elegooofficial/Jupiter/README.md

# Jupiter
Opensource files for ELEGOO Jupiter 6k mono LCD 3D printer
