elegooofficial/Jupiter/Jupiter PCB/Jupiter-Constant-current module/原理图.png

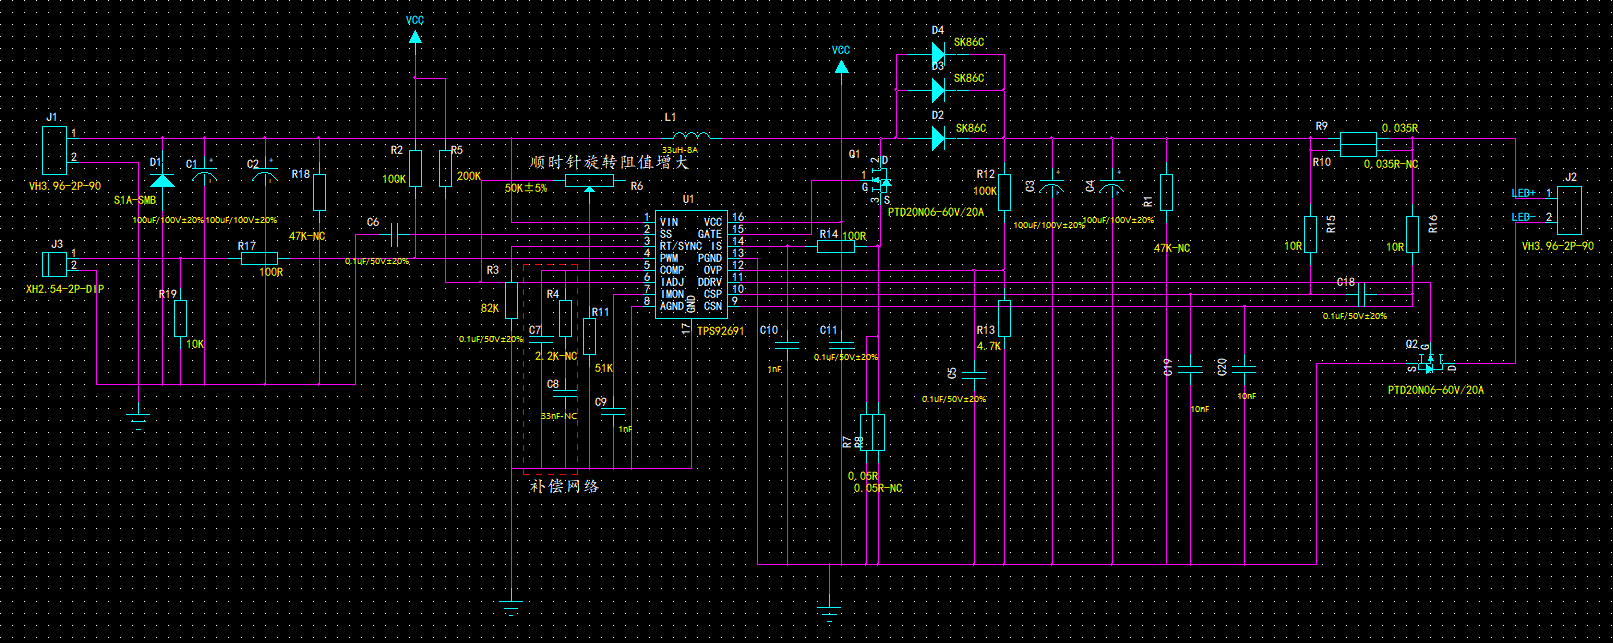
Jupiter PCB/Jupiter-Constant-current module/原理图.png
