elegooofficial/Jupiter/Jupiter BOM-V11.xlsx

研发专用附表 |  |  |  |  |  |  |  | ( Jupiter )BOM
成品料号 |  | 14.0023.01 | 14.0023.02 | 14.0023.03 | 14.0023.05 | 14.0023.04 | 14.0023.06 | S/N | Name | Specification | Qty
取用列 | 不共用物料明细 |  |  |  |  |  |  | 1 | US Power Cord - 1m | Three holes 3*0.824 square, 1m length | 1
#REF! | 料号 | 04.008.0009 | 04.008.0008 | 04.008.0010 | 04.008.0011 | 04.008.0012 | 04.008.0013 | 2 | Jupiter Base Plate | Material: SPCC T=1.5mm, powder black Size: 495*355*62.5mm | 1
#REF! | 名称 | 国标电源线-1m | 美规电源线-1m | 欧规电源线-1m | 英规电源线-1m | 澳规电源线-1m | 巴西规电源线-1m | 3 | Jupiter Bottom Front Left Profile | Material: 6061 aluminum alloy, sandblasted oxidized jujube red Size: 50*25*200mm | 1
#REF! | 规格 | 品字尾 三孔 3*0.75平方 长度1m | 品字尾 三孔 3*0.824平方 长度1m | 品字尾 三孔 3*0.75平方 长度1m | 品字尾 三孔 3*0.75平方 长度1m | 品字尾 三孔 3*0.75平方 长度1m | 品字尾 三孔 3*0.75平方 长度1.0m | 4 | Jupiter Bottom Front Right Profile | Material: 6061 aluminum alloy, sandblasted oxidized jujube red Size: 50*25*200mm | 1
#REF! | 数量 | 1 | 1 | 1 | 1 | 1 | 1 | 5 | Jupiter Bottom Rear Left Profile | Material: 6061 aluminum alloy, sandblasted oxidized black Size: 50*25*200mm | 1
#REF! | 料号 |  |  |  |  |  |  | 6 | Jupiter Bottom Rear Right Profile | Material: 6061 aluminum alloy, sandblasted oxidized black Size: 50*25*200mm | 1
#REF! | 名称 |  |  |  |  |  |  | 7 | Jupiter Bottom Rear Mid Profile | Material: 6061 aluminum alloy, sandblasted oxidized black Size: 50*25*200mm | 1
#REF! | 规格 |  |  |  |  |  |  | 8 | Jupiter Heatsink | Copper tube + heat dissipation aluminum sheet See drawings | 1
#REF! | 数量 |  |  |  |  |  |  | 9 | Jupiter Lens Holder | Plastic parts Size: 100*85*15.4mm | 1
#REF! | 料号 |  |  |  |  |  |  | 10 | Jupiter Lens Silicone Gasket | Material: black silicone Size: 100*85*1.5mm | 1
#REF! | 名称 |  |  |  |  |  |  | 11 | Jupiter Lens Pressing Plate | Material: SPCC powder black Size: 100*85*1mm | 1
#REF! | 规格 |  |  |  |  |  |  | 12 | Jupiter Hood | Material; ABS black Size: 251.6*152.3*141.6mm | 1
#REF! | 数量 | 1 | 1 | 1 | 1 | 1 | 1 | 13 | Jupiter Lens | Size: 83.43*72.3*26mm | 1
 |  |  |  |  |  |  |  | 14 | Jupiter LED Light Board | 60*60*1.5mm, 64 cores UV405nm | 1
#REF! | 料号 | D1 | D2 | D3 | D4 | D5 | D6 | 15 | Jupiter Pressure Booster Board | Boost constant current 24V input | 1
 |  |  |  |  |  |  |  | 16 | Jupiter Cooling Fan | 9225 wire length 100mm, speed 3000r, with 2pin XH2.54 terminal | 1
#REF! | 名称 | D1 | D2 | D3 | D4 | D5 | D6 | 17 | Jupiter PCB Adapter Board | Size: 60*60*1.6 | 1
#REF! | 规格 | D1 | D2 | D3 | D4 | D5 | D6 | 18 | MARS 2 Series USB Adapter Cable | One end is male 90° angle, and the other end is female. Total length 35cm with shield. | 1
 |  |  |  |  |  |  |  | 19 | Jupiter Ethernet Port Extension Cable | RJ45 Ethernet port extension cable with ears, length 0.5M. | 1
#REF! | 数量 | D1 | D2 | D3 | D4 | D5 | D6 | 20 | Jupiter Foot Pads | Specifications: base 50, rod thickness M10, tooth length 15mm | 4
#REF! | 料号 | E1 | E2 | E3 | E4 | E5 | E6 | 21 | Jupiter Medium Plate | Die casting, oil injection black Size: 495.6*355.8*20mm | 1
#REF! | 名称 | E1 | E2 | E3 | E4 | E5 | E6 | 22 | Jupiter Purifier Motherboard | Size: 31*19*1.6 | 1
#REF! | 规格 | E1 | E2 | E3 | E4 | E5 | E6 | 23 | Jupiter Screen Mounting Plate - Oil Injected Black | Die casting, oil injection black Size: 336.4*205.74*10mm | 1
#REF! | 数量 | E1 | E2 | E3 | E4 | E5 | E6 | 24 | Jupiter LCD Screen Module | 12.8-inch screen + TCON + ultra-clear glass OCA bonding | 1
 |  |  |  |  |  |  |  | 25 | Jupiter Screen Protector | Size: 320*190*0.06, with peelable sticker | 2
#REF! | 料号 | F1 | F2 | F3 | F4 | F5 | F6 | 26 | Jupiter Ball Screw Nut Holder | Material: 6061 aluminum alloy, sandblasted oxidized black Size: 50*39*36mm | 1
#REF! | 名称 | F1 | F2 | F3 | F4 | F5 | F6 | 27 | Jupiter Linear Rails Backplane | Material: 6061 aluminum alloy, sandblasted oxidized black Size: 55*158*464mm | 1
#REF! | 规格 | F1 | F2 | F3 | F4 | F5 | F6 | 28 | Jupiter Z-axis Bottom Motor End Cover | Material: 6061 aluminum alloy, sandblasted oxidized black Size: 210*94.5*12mm | 1
#REF! | 数量 | F1 | F2 | F3 | F4 | F5 | F6 | 29 | Jupiter Z-axis Slider Mounting Plate | Material: 6061 aluminum alloy, sandblasted oxidized black Size: 150*106*10mm | 1
#REF! | 料号 | G1 | G2 | G3 | G4 | G5 | G6 | 30 | Jupiter Ball Screw | Ball screw diameter 16 lead 5, length 435mm | 1
#REF! | 名称 | G1 | G2 | G3 | G4 | G5 | G6 | 31 | Jupiter Couplings | Ball screw coupling plum elastic single and double diaphragm φ26*30*10-8 | 1
#REF! | 规格 | G1 | G2 | G3 | G4 | G5 | G6 | 32 | Jupiter Linear Rails + Slider | BGW15CA, total length of 457mm, 1 line rail + 2 sliders | 2
#REF! | 数量 | G1 | G2 | G3 | G4 | G5 | G6 | 33 | Jupiter Bearing Holder | BF 12 bearing holder+26 bearing | 2
 |  |  |  |  |  |  |  | 34 | Jupiter 57 Motor | 57 stepper motor, shaft diameter 8mm | 1
 |  |  |  |  |  |  |  | 35 | Jupiter Lead Screw Lock Nut | Material: Eco-friendly iron black Size: φ22*16 | 1
 |  |  |  |  |  |  |  | 36 | Jupiter Limit Switch Baffle | Material: SPCC T=2.0, Powder Black Size: 88*12.5*12.5mm | 1
 |  |  |  |  |  |  |  | 37 | MARS 2 Series Photoelectric Limit Switch Upper Shell | PC surface tanning processing | 1
 |  |  |  |  |  |  |  | 38 | MARS 2 Series Photoelectric Limit Switch Lower Case | PC surface tanning processing | 1
 |  |  |  |  |  |  |  | 39 | MARS 2 Series Photoelectric Limit Switch PCB | PCB module | 1
 |  |  |  |  |  |  |  | 40 | Jupiter Die Casting Resin Tank | Die casting, oil injection black, size: 406.6*302*36.9mm | 1
 |  |  |  |  |  |  |  | 41 | 12.8-inch FEP2.0 Release Film | Size: 374*247*0.15mm | 3
 |  |  |  |  |  |  |  | 42 | Jupiter Resin Tank Release Film Protective Film | Size: 337*211*0.06, with peelable sticker | 1
 |  |  |  |  |  |  |  | 43 | Jupiter Screen Fixing Tape 1 | Mara tape size: 288.2*7.7*0.08mm | 1
 |  |  |  |  |  |  |  | 44 | Jupiter Screen Fixing Tape 2 | Mara tape size: 180.5*15.5*0.08mm | 2
 |  |  |  |  |  |  |  | 45 | Jupiter Screen Fixing Tape 3 | Mara tape size: 288.2*16.4*0.08mm | 1
 |  |  |  |  |  |  |  | 46 | Jupiter Build Plate | Material: 6061 aluminum alloy, sandblasted build plate surface, non-build surface sandblasted, oxidized black Size: 286*166*12mm | 1
 |  |  |  |  |  |  |  | 47 | Jupiter Resin Tank Stainless Steel Handle | Specifications: φ10 hole spacing 128, height 35 | 2
 |  |  |  |  |  |  |  | 48 | Jupiter Straight Grain Handle | M8x50 regular iron nickel plated, straight grain handle | 2
 |  |  |  |  |  |  |  | 49 | Jupiter Stainless Steel Double Bend Handle | Stainless steel, hole spacing 75mm, height 35mm | 2
 |  |  |  |  |  |  |  | 50 | Juipter L-shaped Handle | M8XR 80 | 1
 |  |  |  |  |  |  |  | 51 | Jupiter Build Plate Spacer Columns | Material: Eco-friendly iron, nickel-plated, silver Size: φ12*59 | 4
 |  |  |  |  |  |  |  | 52 | Jupiter M5 Cap Nut | M5 Cap Nut 304 stainless steel, salt spray test for 24H | 4
 |  |  |  |  |  |  |  | 53 | Jupiter M10 Lock Nut | M10 Lock Nut 304 stainless steel, salt spray test for 24H | 1
 |  |  |  |  |  |  |  | 54 | Jupiter M8 X40 Leveling Set Positioning Dowels | Material: Eco-friendly iron, nickel-plated, silver Size: φ8*40 | 2
 |  |  |  |  |  |  |  | 55 | M8 Gasket | Size: φ8.5*φ35*3mm, 304 stainless steel, salt spray test for 24H | 1
 |  |  |  |  |  |  |  | 56 | Jupiter Cantilever Risers | Material: 6061 aluminum alloy, sandblasted oxidized black Size: 160.5*80*10mm | 2
 |  |  |  |  |  |  |  | 57 | Jupiter Forming Platform Upper Plate | Material: 6061 aluminum alloy, sandblasted oxidized black Size: 180*87*22mm | 1
 |  |  |  |  |  |  |  | 58 | Jupiter Printing Platform Integral Fixing Plate | Material: 6061 aluminum alloy, sandblasted anodized black Size: 160*85*8mm | 1
 |  |  |  |  |  |  |  | 59 | Jupiter Upper Front Left Profile | Material: 6061 aluminum alloy, sandblasted anodized black Size: 47*25*485mm | 1
 |  |  |  |  |  |  |  | 60 | Jupiter Upper Front Right Profile | Material: 6061 aluminum alloy, sandblasted anodized black Size: 47*25*485mm | 1
 |  |  |  |  |  |  |  | 61 | Jupiter Upper Rear Left Profile | Material: 6061 aluminum alloy, sandblasted anodized black Size: 50*25*485mm | 1
 |  |  |  |  |  |  |  | 62 | Jupiter Upper Rear Right Profile | Material: 6061 aluminum alloy, sandblasted anodized black Size: 50*25*485mm | 1
 |  |  |  |  |  |  |  | 63 | Jupiter Bottom Front Panel | Material: Galvanized sheet T=1.0, powder black Size: 486*202*1.0mm | 1
 |  |  |  |  |  |  |  | 64 | Jupiter Bottom Left Panel | Material: SPCC T=1.0, powder black Size: 346*202*1.0mm | 1
 |  |  |  |  |  |  |  | 65 | Jupiter Bottom Rear Panel | Material: SPCC T=1.0, powder black Size: 346*210*1.0mm | 1
 |  |  |  |  |  |  |  | 66 | Jupiter Bottom Right Panel | Material: SPCC T=1.0, powder black Size: 346*210*1.0mm | 1
 |  |  |  |  |  |  |  | 67 | Jupiter Upper Left Panel | Material: SPCC T=1.0, powder black Size: 493.3*346.5*1.0mm | 1
 |  |  |  |  |  |  |  | 68 | Jupiter Upper Right Panel | Material: SPCC T=1.0, powder black Size: 493.3*346.5*1.0mm | 1
 |  |  |  |  |  |  |  | 69 | Jupiter Upper Back Panel | Material: SPCC T=1.0, powder black Size: 493.3*486*1.0mm | 1
 |  |  |  |  |  |  |  | 70 | Jupiter Top Panel | Material: SPCC T=1.0, powder black Size: 495*354*1.0mm | 1
 |  |  |  |  |  |  |  | 71 | Jupiter Door Panel | Material: SPCC T=2.0, powder black Size: 494*498*2mm | 1
 |  |  |  |  |  |  |  | 72 | Jupiter Vent Cover Plate | Material: SPCC T=1.0, powder black Size: 73*73*1mm | 1
 |  |  |  |  |  |  |  | 73 | Jupiter Motherboard | J2, 12.8-inch 6K driver board, FPGA supports 8K resolution | 1
 |  |  |  |  |  |  |  | 74 | Jupiter 5-inch Touch Screen | Size: 131.6*96.6*1.0mm with adhesive sticker | 1
 |  |  |  |  |  |  |  | 75 | Jupiter Door Magnet | Main body material: 45# steel Size: 46*15*12.8mm; with iron block size 44*12*1.4mm | 1
 |  |  |  |  |  |  |  | 76 | Jupiter Hinge | Material: iron, black Dimensions: 50x15x1.0 | 3
 |  |  |  |  |  |  |  | 77 | Jupiter Aluminum Alloy Door Handle | Material: aluminum alloy, silver Hole spacing 160 | 1
 |  |  |  |  |  |  |  | 78 | Jupiter Machine Handle | Material: all plastic, black Size: 110*50*23.5mm, with mounting nut | 2
 |  |  |  |  |  |  |  | 79 | Jupiter DC Terminal | Specifications: 24V, 10A; all copper material, silver | 1
 |  |  |  |  |  |  |  | 80 | Jupiter Power Switch | KCD4 Boat shape 250V AC 16A 4 feet | 1
 |  |  |  |  |  |  |  | 81 | Jupiter Door Window | Material: PMMA, brown Size: 470*430*4mm | 1
 |  |  |  |  |  |  |  | 82 | Jupiter Resin Tank Press Sheet Upper | Material: SPCC T=3, electrophoretic black Size: 353.3*227*3mm | 1
 |  |  |  |  |  |  |  | 83 | Jupiter Resin Tank Press Sheet Bottom | Material: SPCC T=3, electrophoretic black Size: 353.3*227*3mm | 1
 |  |  |  |  |  |  |  | 84 | Jupiter Fan Adapter Cable | Blue green wire, full length 400mm 0.14RV XH2.54-2P | 1
 |  |  |  |  |  |  |  | 85 | Jupiter Purifier Adapter Cable | White grey wire, full length 400mm 0.14RV XH2.54-2P | 1
 |  |  |  |  |  |  |  | 86 | Jupiter Limit Switch Adapter Cable | Black, red and blue wire, full length 400mm 0.14RV XH2.54-3P | 1
 |  |  |  |  |  |  |  | 87 | Jupiter Motor Adapter Cable | Black, green, red and blue wire, full length 400mm 0.34RV, one end XH2.5-4P-DIP, the other end XH2.54-4P | 1
 |  |  |  |  |  |  |  | 88 | Jupiter Lighting Adapter Cable | Red black wire, full length 400mm 0.34RV, one end VH3.96-2P, the other end KF terminal green, 2PIN spacing 5.08 | 1
 |  |  |  |  |  |  |  | 89 | Jupiter Booster Board to Motherboard Cable | Red black wire, full length 400mm, 1.0RV, one end VH3.96-2P, the other end KF terminal green, 2PIN spacing 5.08 | 1
 |  |  |  |  |  |  |  | 90 | Jupiter Purifier Cable | Red black wire, full length 200mm 0.14RV XH2.54-2P | 1
 |  |  |  |  |  |  |  | 91 | Jupiter Limit Switch Cable | Red black wire, full length 200mm 0.14RV XH2.54-3P | 1
 |  |  |  |  |  |  |  | 92 | Jupiter Motor Cable | Black, green, red and blue wire, full length 200mm 0.34RV, one end XH2.5-11P-DIP, the other end XH2.54-4P | 1
 |  |  |  |  |  |  |  | 93 | Jupiter Lighting Cable | Black red wire, full length 710mm 0.34RV, one end SM, the other end VH3.96-2P | 1
 |  |  |  |  |  |  |  | 94 | Jupiter DC Terminal to Motherboard Cable | The red wire is 430mm long, the black wire is 480mm long 1.0RV; one end is KF terminal green, 2PIN spacing 5.08, the red wire at the other end is 6.3 spring terminal + sheath. | 1
 |  |  |  |  |  |  |  | 95 | Jupiter DC Switch Cable | Red wire, full length 80mm 1.0RV, one end of red wire with 6.3 spring terminal + sheath, the other end with tin. | 1
 |  |  |  |  |  |  |  | 96 | Jupiter LED Light Board to Booster Board | Black red wire, full length 250mm 1.0RV, one end VH3.96 -2P, the other end with tin. | 1
 |  |  |  |  |  |  |  | 97 | Jupiter LED Light | 2 lights in series, full length 150mm 0.34RV SM 2700 lumens | 1
 |  |  |  |  |  |  |  | 98 | Jupiter LCD Screen Cable Layout | Same direction, full length 250mm, impedance 100 40pin | 1
 |  |  |  |  |  |  |  | 99 | Jupiter Touch Screen Cable Layout | Co-directional unidirectional shielding, length 150mm, 0.5 spacing 40pin | 1
 |  |  |  |  |  |  |  | 100 | Jupiter Adapter | Specifications: 24V 7.5A Dc5.5-2.5 elbow, cable length 1.2m | 1
 |  |  |  |  |  |  |  | 101 | Jupiter Handle Bolt | Material: Eco-friendly iron, nickel-plated, silver Size: φ10*70 | 1
 |  |  |  |  |  |  |  | 102 | Jupiter Profile Fastening Dowels | M8*30 fastening positioning pin | 8
 |  |  |  |  |  |  |  | 103 | Headless Hexagon Socket Head Screws | M5*6 304 stainless steel concave end, salt spray test for 24H | 8
 |  |  |  |  |  |  |  | 104 | M4 Nuts | M4 stainless steel hex nut | 9
 |  |  |  |  |  |  |  | 105 | M4 Flange Nuts | M4 flange nut, stainless steel 304 silver, salt spray test for 24H | 6
 |  |  |  |  |  |  |  | 106 | Cup Head Hexagon Socket Screws | M4*8 carbon steel, hardened, black zinc plated, salt spray test for 24H | 4
 |  |  |  |  |  |  |  | 107 | Button Head Hexagon Socket Screws | M4*6 carbon steel, hardened, black zinc plated, salt spray test for 24H | 81
 |  |  |  |  |  |  |  | 108 | Button Head Hexagon Socket Screws | M3*6 carbon steel, hardened, black zinc plated, salt spray test for 24H | 4
 |  |  |  |  |  |  |  | 109 | Cup Head Hexagon Socket Screws | M5*20 stainless steel 304 silver, salt spray test for 24H | 18
 |  |  |  |  |  |  |  | 110 | Cup Head Hexagon Socket Screws | M3*5 stainless steel 304 silver, salt spra test for 24H | 26
 |  |  |  |  |  |  |  | 111 | Cup Head Hexagon Socket Screws | M4*8 stainless steel 304 silver, salt spray test for 24H | 14
 |  |  |  |  |  |  |  | 112 | Cup Head Hexagon Socket Screws | M4*22 stainless steel 304 silver, salt spray test for 24H | 4
 |  |  |  |  |  |  |  | 113 | Cup Head Hexagon Socket Screws | M3*14 stainless steel 304 silver, salt spray test for 24H | 2
 |  |  |  |  |  |  |  | 114 | Flat Head Hexagon Socket Screws | M4*8 stainless steel 304 silver, salt spray test for 24H | 8
 |  |  |  |  |  |  |  | 115 | Flat Head Hexagon Socket Screws | M4*6 stainless steel 304 silver, salt spray test for 24H | 47
 |  |  |  |  |  |  |  | 116 | Flat Head Hexagon Socket Screws | M4*14 stainless steel 304 silver, salt spray test for 24H | 25
 |  |  |  |  |  |  |  | 117 | Jupiter Leveling Screws | Cup head hexagon socket screws, M5*12 stainless steel 304 silver, salt spray test for 24H, chamfered bottom of thread, smooth bottom of screw | 4
 |  |  |  |  |  |  |  | 118 | Cup Head Hexagon Socket Screws | M4*10 stainless steel 304 silver, salt spray test for 24H | 24
 |  |  |  |  |  |  |  | 119 | Cup Head Hexagon Socket Screws | M5*12 stainless steel 304 silver, salt spray test for 24H | 38
 |  |  |  |  |  |  |  | 120 | Cup Head Hexagon Socket Screws | M4*14 stainless steel 304 silver, salt spray test for 24H | 16
 |  |  |  |  |  |  |  | 121 | Cup Head Hexagon Socket Screws | M5*30 stainless steel 304 silver, salt spray test for 24H | 4
 |  |  |  |  |  |  |  | 122 | Cup Head Hexagon Socket Screws | M5*14 stainless steel 304 silver, salt spray test for 24H | 14
 |  |  |  |  |  |  |  | 123 | Cup Head Hexagon Socket Screws | M6*35 stainless steel 304 silver, salt spray test for 24H | 4
 |  |  |  |  |  |  |  | 124 | Cup Head Hexagon Socket Screws | M3*10 stainless steel 304 silver, salt spray test for 24H | 4
 |  |  |  |  |  |  |  | 125 | Button Head Hexagon Socket Screws Black | M4*10 carbon steel, hardened, black zinc plated, salt spray test for 24H | 9
 |  |  |  |  |  |  |  | 126 | Flat Head Hexagon Socket Screws | M3*5 carbon steel, hardened, black zinc plated, salt spray test for 24H | 2
 |  |  |  |  |  |  |  | 127 | Flat Head Hexagon Socket Screws | M3*8 carbon steel, hardened, black zinc plated, salt spray test for 24H | 2
 |  |  |  |  |  |  |  | 128 | Spring | Die spring, nickel-plated, treatment salt spray for 24H, outer diameter 8mm, length 15mm | 4
 |  |  |  |  |  |  |  | 129 | Jupiter Protective Film Removable | 75 filament synthetic paper complex coating film, 30*10mm glueless part 7mm | 2
 |  |  |  |  |  |  |  | 130 | CHITUBOX Pro Key Card | Card size: 85.6*53.98mm + key reference code | 1
 |  |  |  |  |  |  |  | 131 | U Disk | 4G | 1
 |  |  |  |  |  |  |  | 132 | Acetate Tape | Width 10mm, black (tape length 30m/roll) | 0.12
 |  |  |  |  |  |  |  | 133 | Jupiter Cable Fastener | 13*10*7mm, black, clip 2-3mm wide | 4
 |  |  |  |  |  |  |  | 134 | Scraper | Specifications: 4 inch, oblique incision | 1
 |  |  |  |  |  |  |  | 135 | Jupiter Auto Feeding Bottle Cap |  | 5
 |  |  |  |  |  |  |  | 136 | SAT S USB Air Purifier | 44*44*169mm; with user manual | 1
 |  |  |  |  |  |  |  | 137 | Mask |  | 2
 |  |  |  |  |  |  |  | 138 | Gloves | Latex gloves, large size | 2双
 |  |  |  |  |  |  |  | 139 | Plastic Scraper | Material: PP, yellow | 1
 |  |  |  |  |  |  |  | 140 | Hexagon Socket Head Screwdriver with Straight Handle | H2.5*75mm; chrome vanadium steel | 1
 |  |  |  |  |  |  |  | 141 | Allen Wrench | M3 full length 91mm, length error ±5mm, S2 alloy | 1
 |  |  |  |  |  |  |  | 142 | Allen Wrench | M4 length 90mm, S2 alloy | 1
 |  |  |  |  |  |  |  | 143 | Paper Funnel |  | 10
 |  |  |  |  |  |  |  | 144 | Pliers | Long 130mm, wide 76mm, stainless steel jaws, Non-slip rubber handle | 1
 |  |  |  |  |  |  |  | 145 | Nylon Cable Tie | 2*150mm, black | 5
 |  |  |  |  |  |  |  | 146 | Jupiter Leveling Instruction Card | 296*176*0.15mm, 157g double copper glue, single-sided printing | 1
 |  |  |  |  |  |  |  | 147 | Jupiter User Manual | 150*150mm, saddle stud, matte powder 105g | 1
 |  |  |  |  |  |  |  | 148 | Zip-lock Bag | 100*150mm | 3
 |  |  |  |  |  |  |  | 149 | Zip-lock Bag | 180mm*160mm*0.06mm | 1
 |  |  |  |  |  |  |  | 150 | Jupiter Label Nameplate | 90*55mm, single side self-adhesive | 1
 |  |  |  |  |  |  |  | 151 | Jupiter Slicing Software | CHITUBOX | 1
 |  |  |  |  |  |  |  | 152 | Heat Shrink Tube | Specifications: φ3*20mm, inner diameter 3.5mm; wall thickness 0.2mm | 2
 |  |  |  |  |  |  |  | 153 | Thermal Conductive Silicone Grease | Thermal paste, gold, thermal conductivity greater than 3.05 | 0.2
 |  |  |  |  |  |  |  | 154 | Jupiter Accessories Box | Material: PP, ink black; Size: 334*235*60mm | 1
 |  |  |  |  |  |  |  | 155 | Jupiter FEP Film Packaging Box | 48*48*273mm, 250g, single powder+wf | 1
 |  |  |  |  |  |  |  | 156 | Jupiter Carton Box | Material: K6#K three pits; Box size: 630*435*775mm | 1
 |  |  |  |  |  |  |  | 157 | Jupiter Carton Lid | Material: K6#K three pits; Box lid size: 635*100*455mm | 2
 |  |  |  |  |  |  |  | 158 | Jupiter Upper Foam | White EPE; Size 600*420*280mm | 1
 |  |  |  |  |  |  |  | 159 | Jupiter Bottom Foam | White EPE; Size 600*420*335mm | 1
 |  |  |  |  |  |  |  | 160 | Jupiter Screen Protection Foam | White EPE; Size 155*18*100mm | 1
 |  |  |  |  |  |  |  | 161 | Jupiter Internal Foam 1 | White EPE; Size 480*445*10mm | 1
 |  |  |  |  |  |  |  | 162 | Jupiter Internal Foam 2 | White EPE; Size 490*260*373mm | 1
 |  |  |  |  |  |  |  | 163 | Jupiter Internal Foam 3 | White EPE; Size 320*185*105mm | 1
 |  |  |  |  |  |  |  | 164 | Jupiter Shipping Box Lid | Size: 685*505*100mm, Material: high-strength special reloading paper, face paper and lining paper 447g, corrugated paper 150g, medium paper 140g (7 layers) | 2
 |  |  |  |  |  |  |  | 165 | Jupiter Shipping Box Body | Size: 665*490*810mm, Material: high-strength special reloading paper, face paper and lining paper 447g, corrugated paper 150g, medium paper 140g (7 layers) | 1
 |  |  |  |  |  |  |  | 166 | Jupiter Upper Double-sided Tape | 3M 9448A, temperature resistance 210 degrees, double-sided adhesive black, size 290*4*0.15mm | 1
 |  |  |  |  |  |  |  | 167 | Jupiter Bottom Double-sided Tape | 3M 9448A, temperature resistance 210 degrees, double-sided adhesive black, size 290*1.8*0.15mm | 1
 |  |  |  |  |  |  |  | 168 | Jupiter Double Sided Tape | 3M 9448A, temperature resistance 210 degrees, double-sided adhesive black, size 154*6*0.15mm | 2
 |  |  |  |  |  |  |  | 169 | Jupiter Build Plate Protection EPE | White EPE conventional 18KG; size: 280*80*30mm, dimensional tolerance ±3mm | 2
