elegooofficial/Jupiter/Jupiter PCB/Jupiter-Constant-current module/BOM-08.001.0011-Jupiter升压板-20220616-V5.0.xlsx

项目 | 用量 | 参考编号 | 元件规格名称 | Value | 指定供应商 | 参考购买链接
1 | 5 | C5,C6,C7,C11,C18 | 0603,0.1uF/50V±20% | 0.1uF | * | *
2 | 2 | C19,C20 | 0603,10nF/50V±20% | 10nF | * | *
3 | 2 | C9.C10 | 0603,1nF/50V±20% | 1nF | * | *
4 | 2 | R2,R12 | 0603,100K±1% | 100K | * | *
5 | 2 | R14,R17 | 0603,100R±1% | 100R | * | *
6 | 2 | R15,R16 | 0603,10R±1% | 10R | * | *
7 | 1 | R5 | 0603,200K±1% | 200K | * | *
8 | 1 | R13 | 0603,4.7K±1% | 4.7K | * | *
9 | 1 | R19 | 0603,10K±1% | 10K | * | *
10 | 1 | R11 | 0603,50K±1% | 50K | * | *
11 | 1 | R3 | 0603,82K±1% | 82K | * | *
12 | 1 | R9 | 2512,0.035R±1% | 0.035R | 中国台湾-大毅 | https://item.szlcsc.com/370321.html
13 | 1 | R7 | 2512,0.05R±1% | 0.05R | 中国台湾-厚生 | https://item.szlcsc.com/138981.html
14 | 4 | C1,C2,C3,C4 | CAP-DIP-L10-H16,100uF/100V±20% | 100uF/100V±20% | 中国-湖南艾华AISHI | https://item.szlcsc.com/107895.html
15 | 1 | D1 | S1A | S1A | 中国-山东晶导微电子 | https://item.szlcsc.com/436172.html
16 | 2 | D2,D4 | SK86C | SK86C-60V/8A | 中国-江苏辰达行电子MDD | https://item.szlcsc.com/65405.html
17 | 1 | L1 | 33uH | 33uH-8A | 韩国-顺磁Sunltech | https://item.szlcsc.com/938420.html
18 | 1 | Q2 | AS3100 | NMOS-AS3100 | 中国台湾-安邦AnBon | https://item.taobao.com/item.htm?id=649348877533&ns=1&abbucket=2
19 | 1 | Q1 | PTD20N06 | PTD20N06-60V/20A | 中国-深圳市迪浦电子有限公司PUOLOP(迪浦) | https://item.szlcsc.com/486296.html
20 | 1 | R6 | 3296W,50K±5% | 50K±5% | 中国-成都国盛科技有限公司BocHen(博晨) | https://item.szlcsc.com/120180.html
21 | 1 | U1 | TPS92691PWPR | TPS92691PWPR | 美国-德州仪器TI | https://item.taobao.com/item.htm?id=649805442109&ns=1&abbucket=2
22 | 2 | J1,J2 | VH3.96-2P-90,弯针 | VH3.96-2P-90 | * | *
23 | 1 | J3 | XH2.54-2P,直针 |  | * | *
