elegooofficial/Jupiter/Jupiter PCB/Jupiter-PCB Adapter Board/Jupiter PCB BOM.xls

数量 | 参考编号 | 元件名称 | 规格型号
4 | J1,J2,J3,J4 | XH2.54-2P | 直针
2 | J5,J6 | XH2.54-3P | 直针
2 | J7,J10 | XH2.54-4P | 直针
2 | J8,J9 | VH3.96-2P | 直针
1 | C1 | 0.1uF/50V±20% | 0603
1 | C2 | 10uF/50V±20% | 1206
