elegooofficial/Jupiter/Jupiter Mechanical/ASM/Jupiter Upper Back Panel.SLDPRT

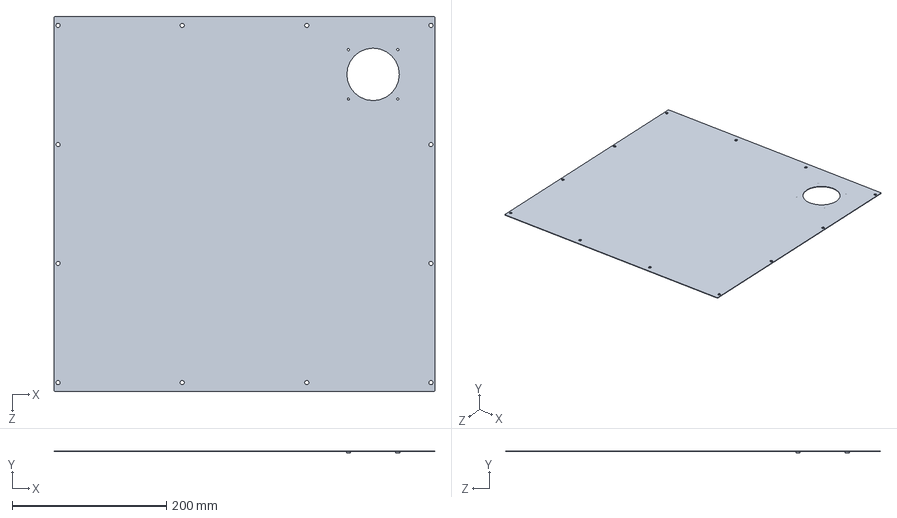
[picture p2: CAD file, 2022-12-16]
Jupiter Mechanical/ASM/Jupiter Upper Back Panel.SLDPRT
493.3 x 3.00 x 486.0 mm
