elegooofficial/Jupiter/Jupiter Mechanical/STP/Jupiter Bottom Front Panel.STEP

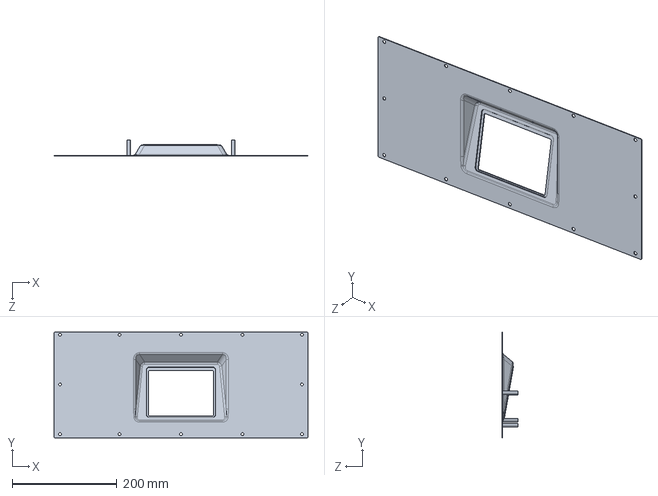
[picture p3: CAD file, 2022-12-16]
Jupiter Mechanical/STP/Jupiter Bottom Front Panel.STEP
486.0 x 202.0 x 30.0 mm
