elegooofficial/Jupiter/Jupiter Mechanical/ASM/Jupiter Door Panel.SLDPRT

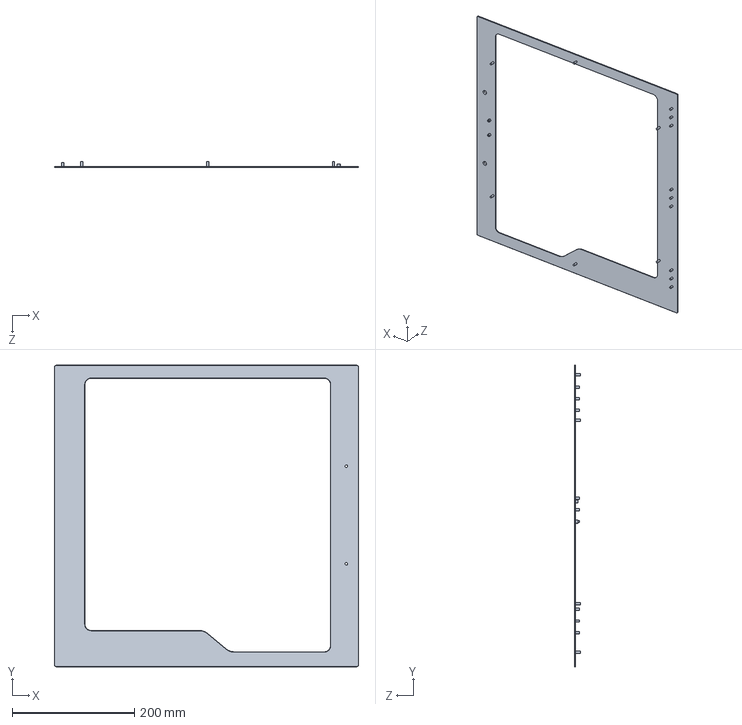
[picture p4: CAD file, 2022-12-16]
Jupiter Mechanical/ASM/Jupiter Door Panel.SLDPRT
498.0 x 494.0 x 10.0 mm
