elegooofficial/Jupiter/Jupiter Mechanical/ASM/Jupiter Bearing Holder.SLDPRT

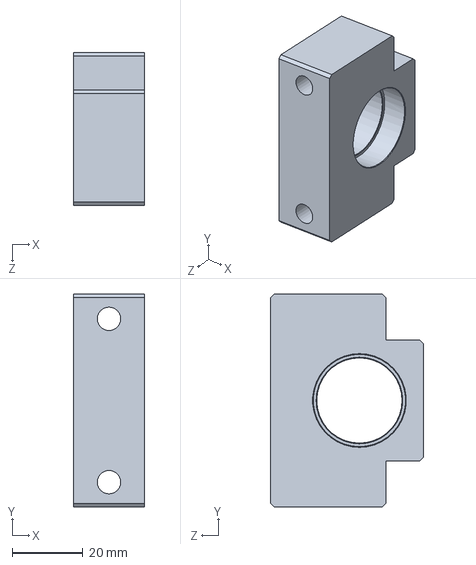
[picture p6: CAD file, 2022-12-16]
Jupiter Mechanical/ASM/Jupiter Bearing Holder.SLDPRT
20.0 x 60.0 x 43.0 mm
