elegooofficial/Jupiter/Jupiter Mechanical/STP/Jupiter Printing Platform Integral Fixing Plate.STEP

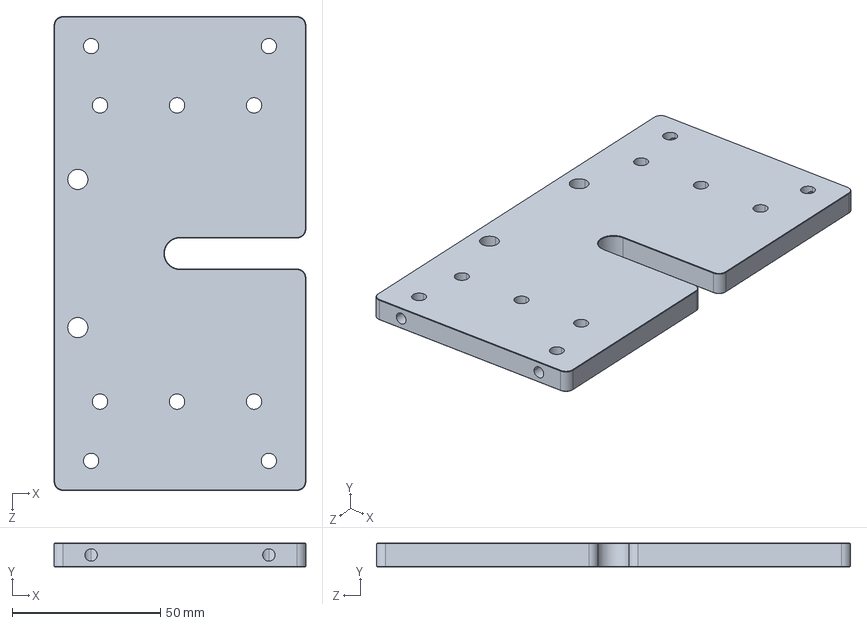
[picture p7: CAD file, 2022-12-16]
Jupiter Mechanical/STP/Jupiter Printing Platform Integral Fixing Plate.STEP
85.0 x 8.00 x 160.0 mm
