elegooofficial/Jupiter/Jupiter Mechanical/ASM/Jupiter Z-axis Slider Mounting Plate.SLDPRT

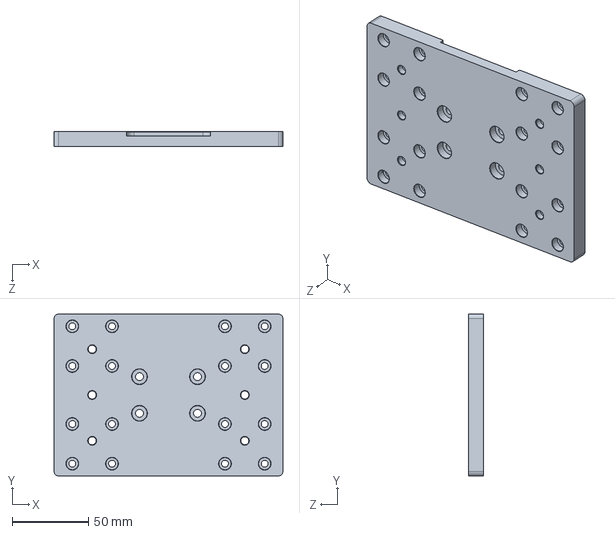
[picture p8: CAD file, 2022-12-16]
Jupiter Mechanical/ASM/Jupiter Z-axis Slider Mounting Plate.SLDPRT
150.0 x 106.0 x 10.0 mm
