elegooofficial/Jupiter/Jupiter Mechanical/STP/Jupiter Upper Front Left Profile.STEP

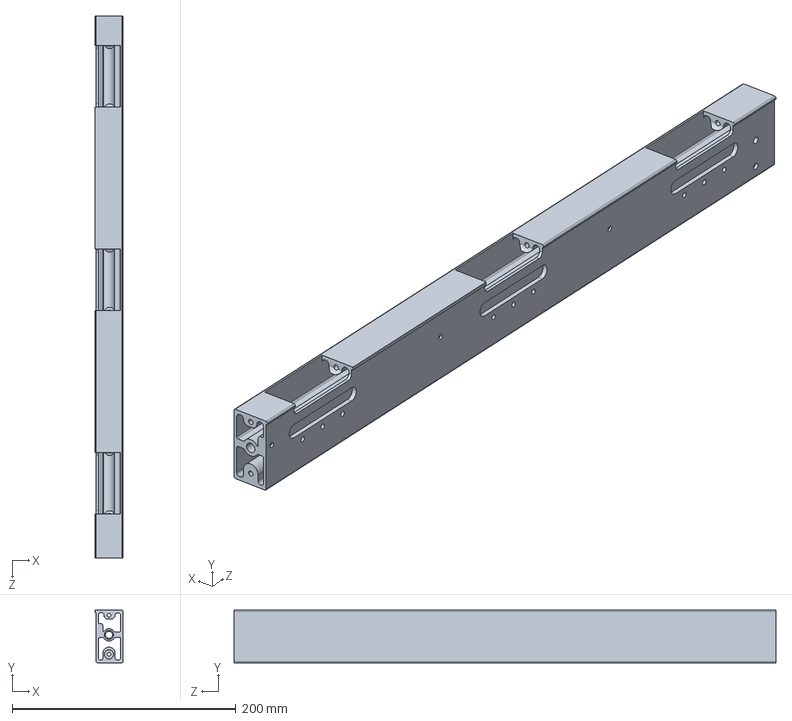
[picture p9: CAD file, 2022-12-16]
Jupiter Mechanical/STP/Jupiter Upper Front Left Profile.STEP
25.0 x 47.0 x 485.0 mm
