elegooofficial/Jupiter/Jupiter Mechanical/ASM/Jupiter Bottom Rear Panel.SLDPRT

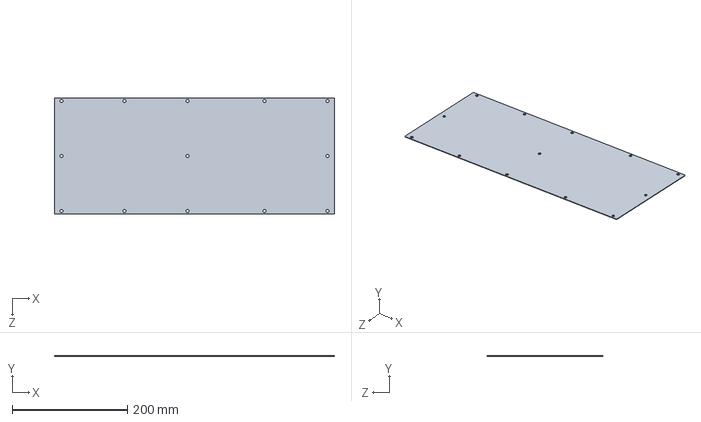
[picture p10: CAD file, 2022-12-16]
Jupiter Mechanical/ASM/Jupiter Bottom Rear Panel.SLDPRT
486.5 x 1.00 x 202.0 mm
