elegooofficial/Jupiter/Jupiter Mechanical/ASM/Jupiter Bottom Rear Left Profile.SLDPRT

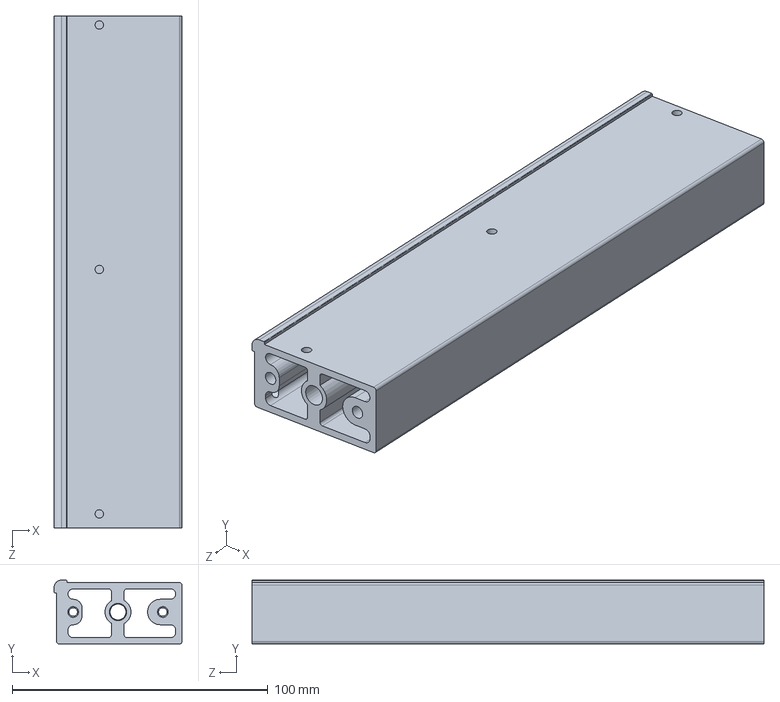
[picture p11: CAD file, 2022-12-16]
Jupiter Mechanical/ASM/Jupiter Bottom Rear Left Profile.SLDPRT
50.0 x 25.0 x 200.0 mm
