elegooofficial/Jupiter/Jupiter Mechanical/STP/Jupiter Bottom Left Panel.STEP

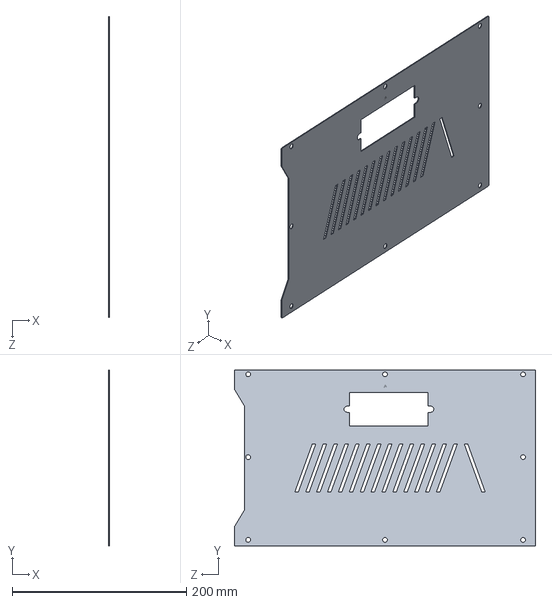
[picture p12: CAD file, 2022-12-16]
Jupiter Mechanical/STP/Jupiter Bottom Left Panel.STEP
1.00 x 202.0 x 346.0 mm
