elegooofficial/Jupiter/Jupiter Mechanical/ASM/Jupiter Cantilever Risers.SLDPRT

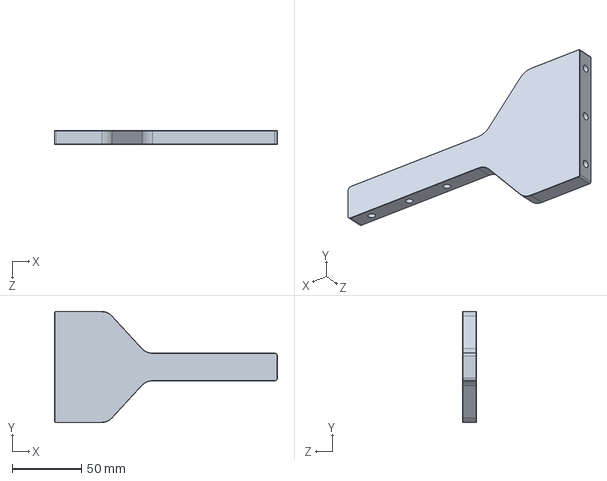
[picture p13: CAD file, 2022-12-16]
Jupiter Mechanical/ASM/Jupiter Cantilever Risers.SLDPRT
160.5 x 80.0 x 10.0 mm
