elegooofficial/Jupiter/Jupiter Mechanical/ASM/Jupiter Vent Cover Plate.SLDPRT

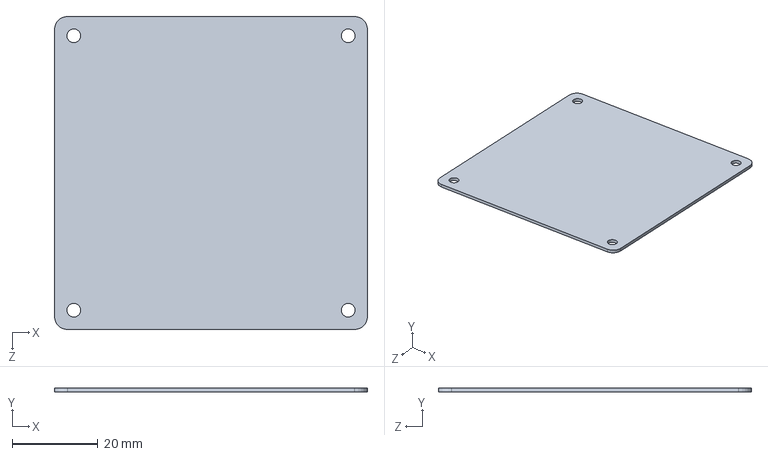
[picture p14: CAD file, 2022-12-16]
Jupiter Mechanical/ASM/Jupiter Vent Cover Plate.SLDPRT
73.0 x 1.00 x 73.0 mm
