elegooofficial/Jupiter/Jupiter Mechanical/STP/Jupiter Limit Switch Baffle.STEP

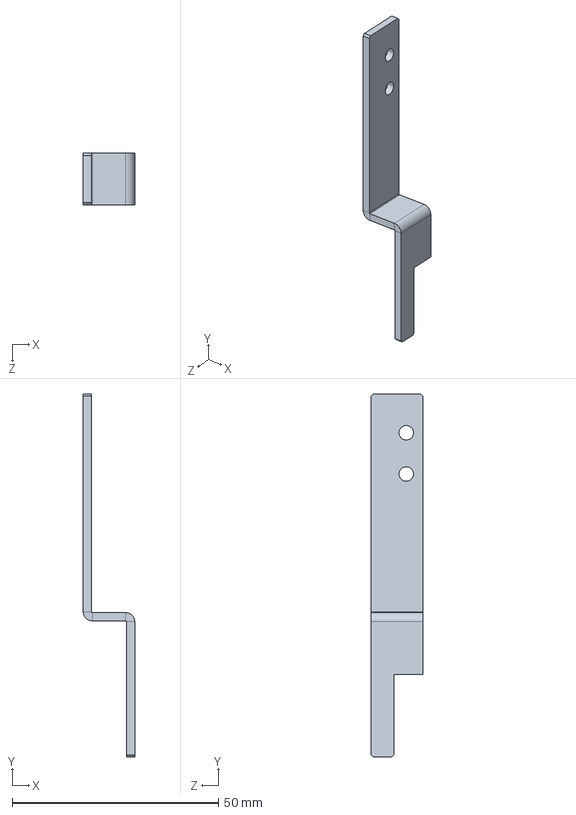
[picture p15: CAD file, 2022-12-16]
Jupiter Mechanical/STP/Jupiter Limit Switch Baffle.STEP
12.5 x 88.0 x 12.5 mm
