elegooofficial/Jupiter/Jupiter Mechanical/ASM/Jupiter Door Window.SLDPRT

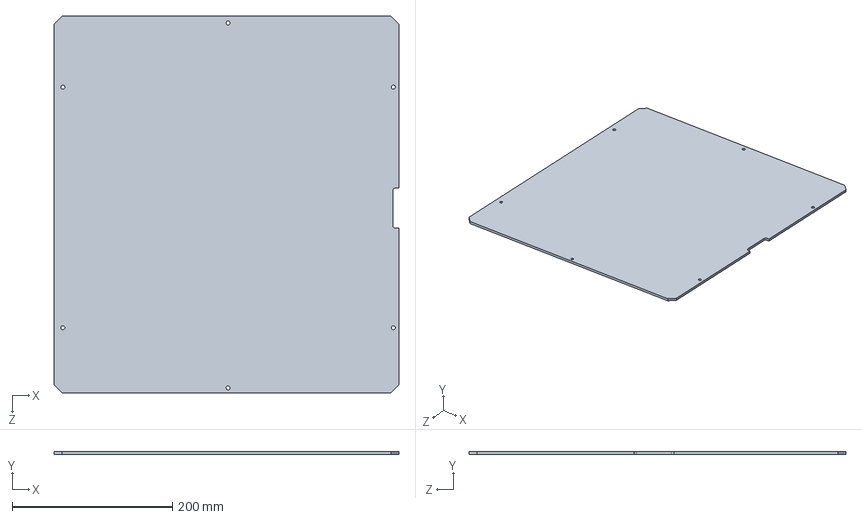
[picture p16: CAD file, 2022-12-16]
Jupiter Mechanical/ASM/Jupiter Door Window.SLDPRT
430.0 x 4.00 x 470.0 mm
