elegooofficial/Jupiter/Jupiter Mechanical/STP/Jupiter Upper Left Panel.STEP

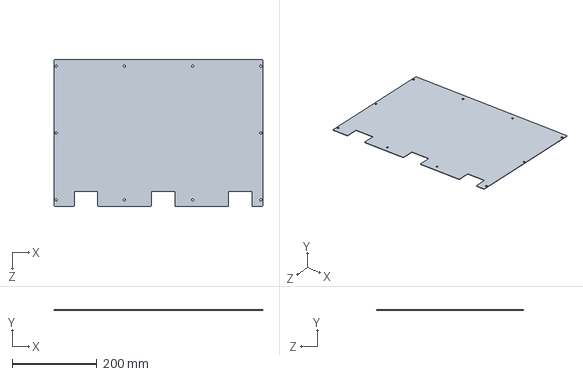
[picture p17: CAD file, 2022-12-16]
Jupiter Mechanical/STP/Jupiter Upper Left Panel.STEP
493.3 x 1.00 x 346.5 mm
