elegooofficial/Jupiter/Jupiter Mechanical/ASM/Jupiter Forming Platform Upper Plate.SLDPRT

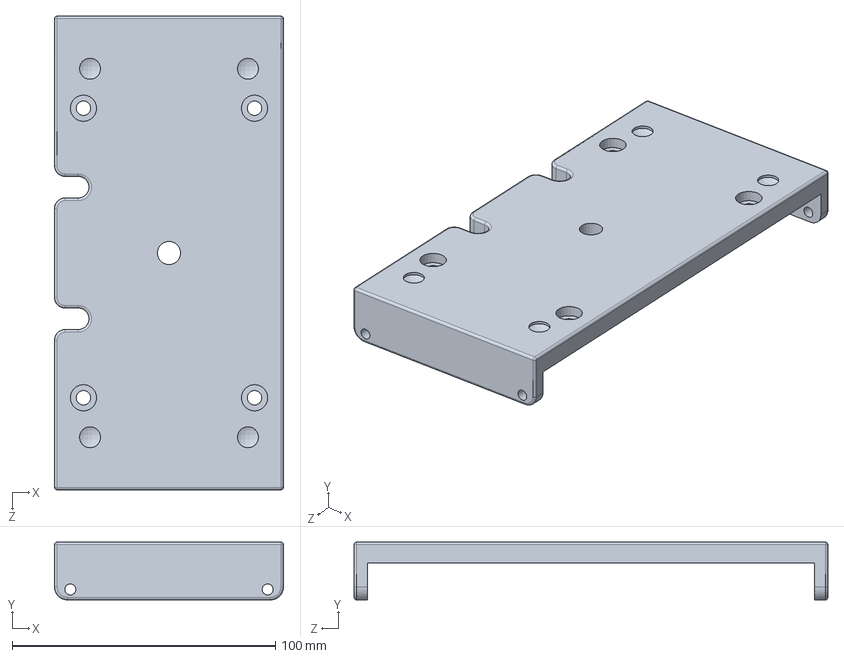
[picture p18: CAD file, 2022-12-16]
Jupiter Mechanical/ASM/Jupiter Forming Platform Upper Plate.SLDPRT
87.0 x 22.0 x 180.0 mm
