elegooofficial/Jupiter/Jupiter Mechanical/STP/Jupiter Lens Pressing Plate.STEP

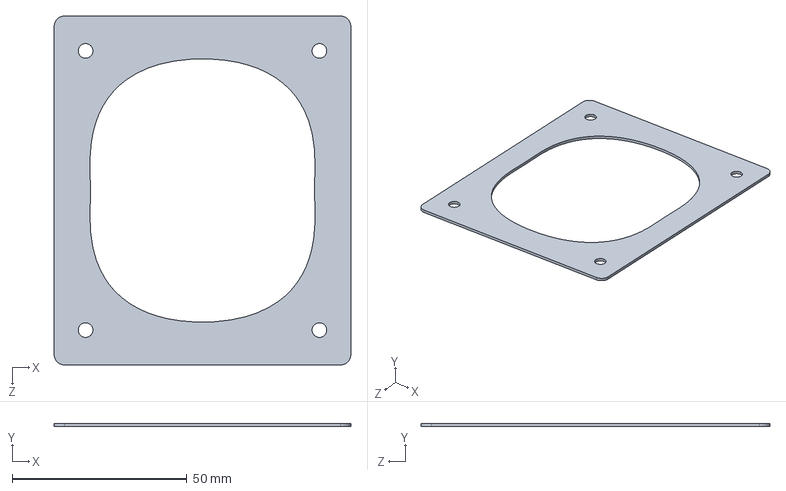
[picture p19: CAD file, 2022-12-16]
Jupiter Mechanical/STP/Jupiter Lens Pressing Plate.STEP
85.0 x 1.00 x 100.0 mm
