elegooofficial/Jupiter/Jupiter Mechanical/ASM/Jupiter Medium Plate.SLDPRT

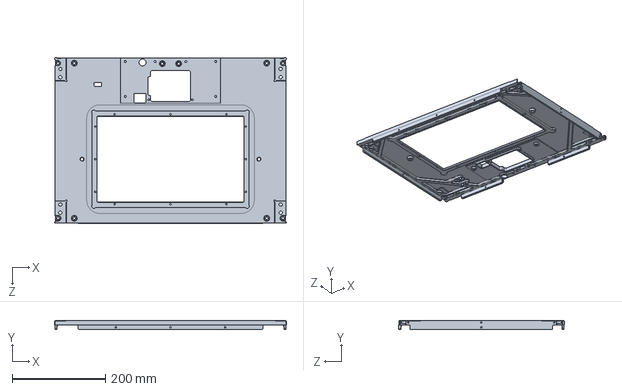
[picture p20: CAD file, 2022-12-16]
Jupiter Mechanical/ASM/Jupiter Medium Plate.SLDPRT
498.0 x 20.0 x 357.0 mm
