elegooofficial/Jupiter/Jupiter Mechanical/STP/Jupiter Screen Mounting Plate - Oil Injected Black.STEP

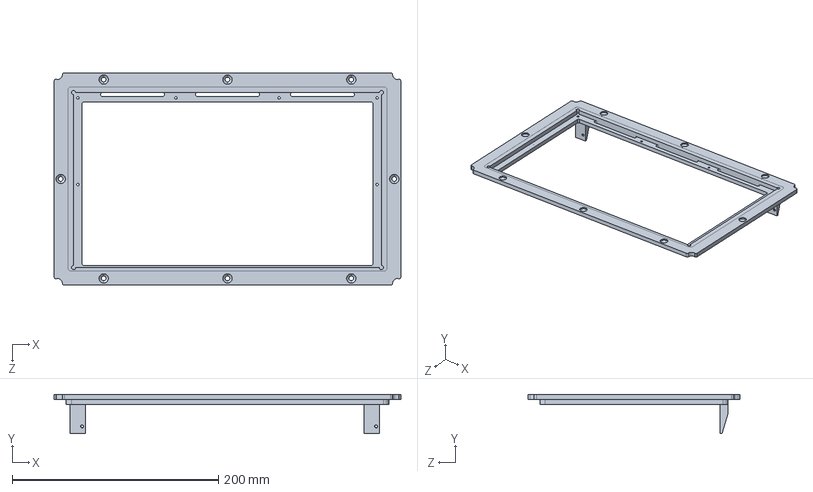
[picture p21: CAD file, 2022-12-16]
Jupiter Mechanical/STP/Jupiter Screen Mounting Plate - Oil Injected Black.STEP
336.4 x 38.0 x 205.7 mm
