elegooofficial/Jupiter/Jupiter Mechanical/ASM/Jupiter Heatsink.SLDPRT

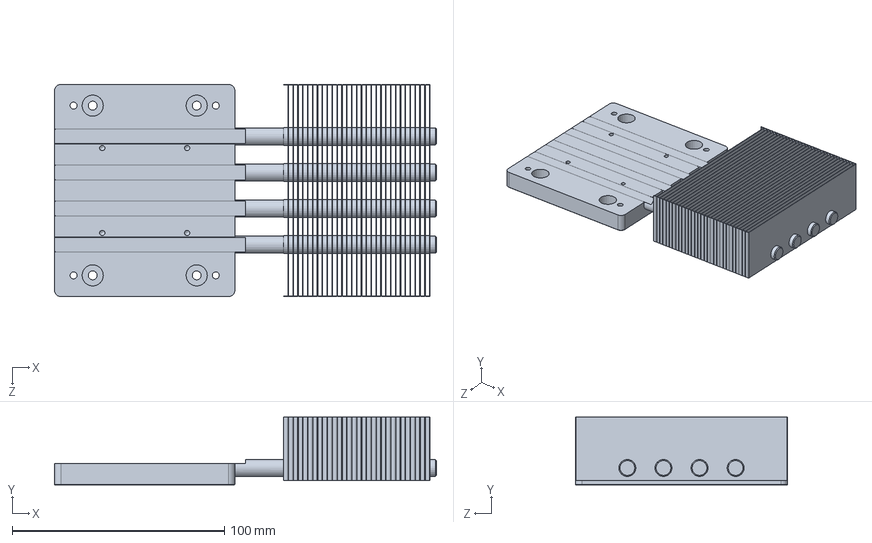
[picture p22: CAD file, 2022-12-16]
Jupiter Mechanical/ASM/Jupiter Heatsink.SLDPRT
180.0 x 32.0 x 100.0 mm
