elegooofficial/Jupiter/Jupiter Mechanical/ASM/Jupiter Base Plate.SLDPRT

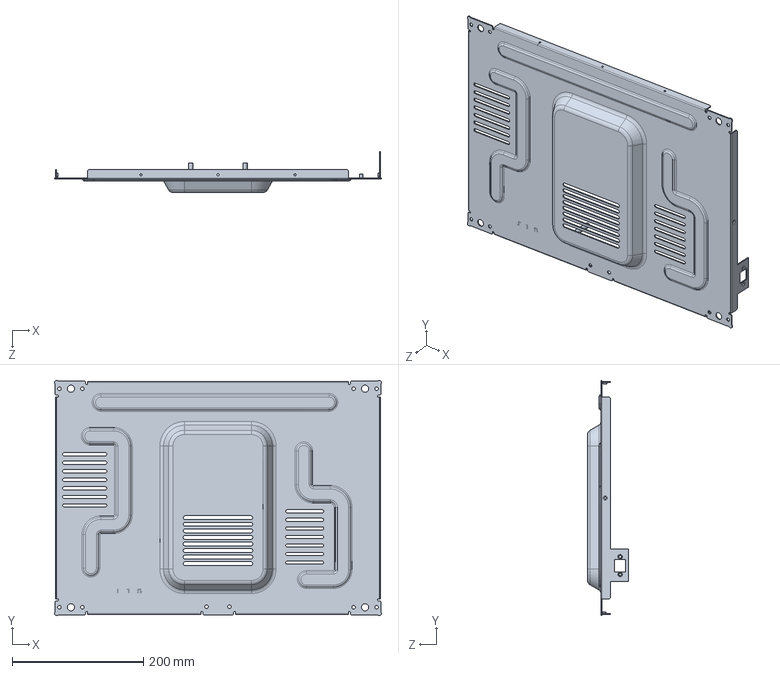
[picture p23: CAD file, 2022-12-16]
Jupiter Mechanical/ASM/Jupiter Base Plate.SLDPRT
498.0 x 358.0 x 62.5 mm
