elegooofficial/Jupiter/Jupiter Mechanical/ASM/Jupiter Linear Rails Backplane.SLDPRT

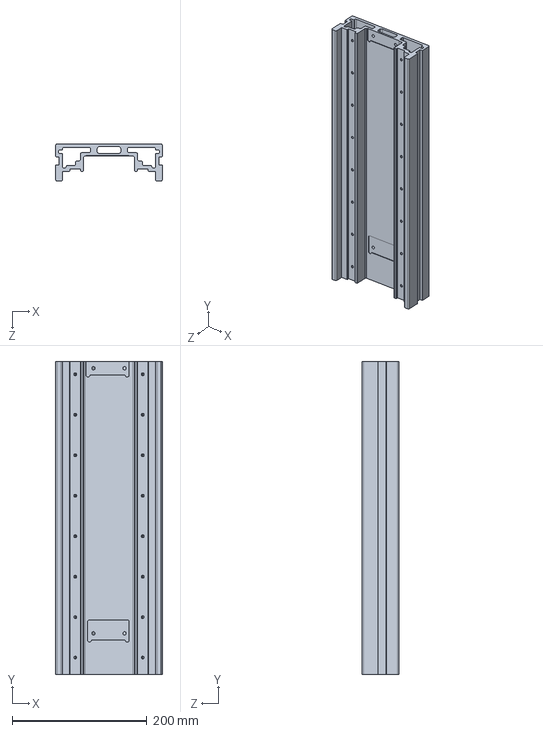
[picture p24: CAD file, 2022-12-16]
Jupiter Mechanical/ASM/Jupiter Linear Rails Backplane.SLDPRT
158.0 x 464.0 x 55.0 mm
