elegooofficial/Jupiter/Jupiter Mechanical/ASM/Jupiter Lens Holder.SLDPRT

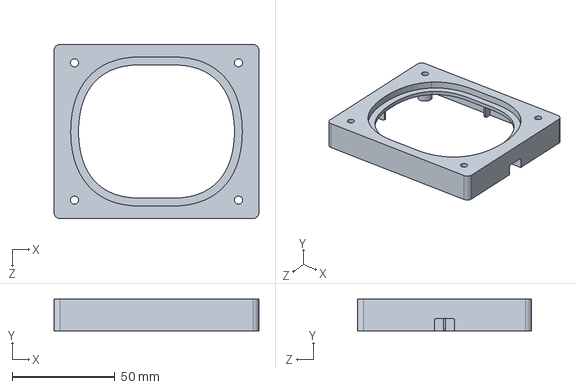
[picture p25: CAD file, 2022-12-16]
Jupiter Mechanical/ASM/Jupiter Lens Holder.SLDPRT
100.0 x 15.4 x 85.0 mm
