elegooofficial/Jupiter/Jupiter Mechanical/ASM/Jupiter Upper Rear Left Profile.SLDPRT

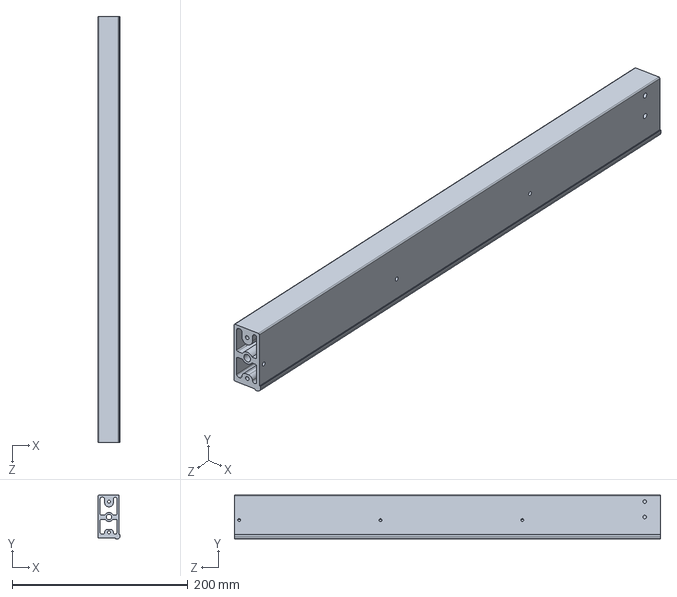
[picture p26: CAD file, 2022-12-16]
Jupiter Mechanical/ASM/Jupiter Upper Rear Left Profile.SLDPRT
25.0 x 50.0 x 485.0 mm
