elegooofficial/Jupiter/Jupiter Mechanical/ASM/Jupiter Upper Right Panel.SLDPRT

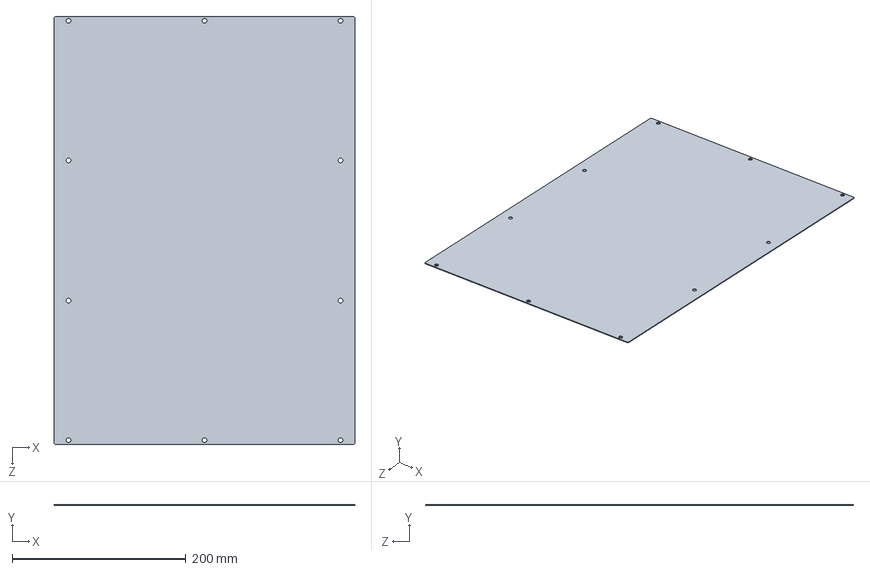
[picture p27: CAD file, 2022-12-16]
Jupiter Mechanical/ASM/Jupiter Upper Right Panel.SLDPRT
346.5 x 1 x 493.3 mm
