elegooofficial/Jupiter/Jupiter Mechanical/STP/Jupiter Lens.stp

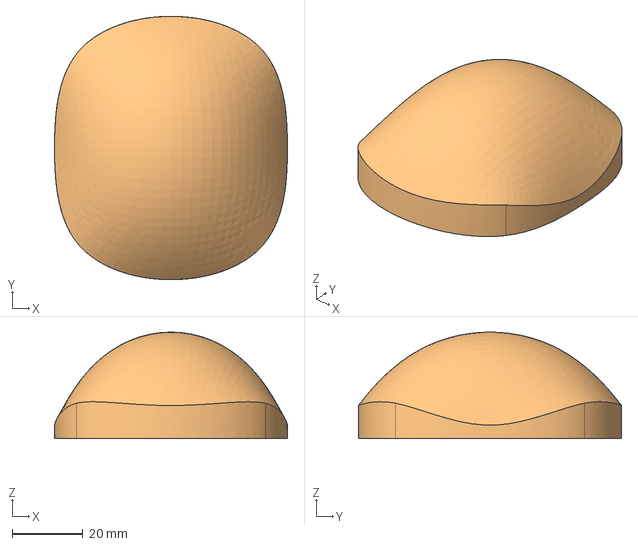
[picture p28: CAD file, 2022-12-16]
Jupiter Mechanical/STP/Jupiter Lens.stp
65.8 x 74.3 x 44.0 mm
