elegooofficial/Jupiter/Jupiter Mechanical/STP/Jupiter Die Casting Resin Tank.STEP

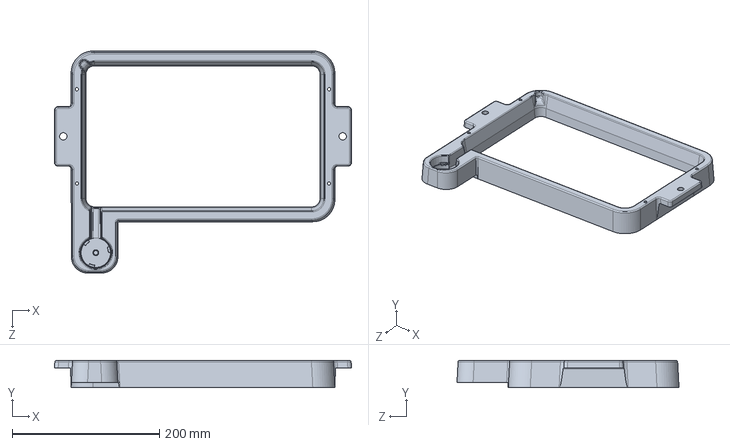
[picture p29: CAD file, 2022-12-16]
Jupiter Mechanical/STP/Jupiter Die Casting Resin Tank.STEP
403.4 x 36.9 x 301.6 mm
