elegooofficial/Jupiter/Jupiter Mechanical/STP/Jupiter Base Plate.STEP

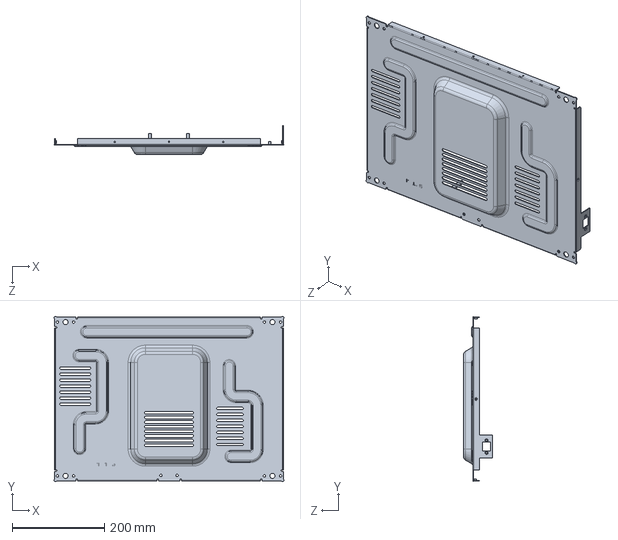
[picture p30: CAD file, 2022-12-16]
Jupiter Mechanical/STP/Jupiter Base Plate.STEP
498.0 x 358.0 x 62.5 mm
