elegooofficial/Jupiter/Jupiter Mechanical/STP/Jupiter Z-axis Bottom Motor End Cover.STEP

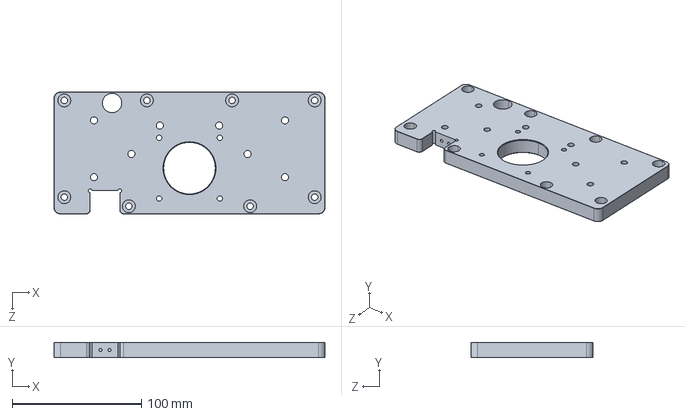
[picture p31: CAD file, 2022-12-16]
Jupiter Mechanical/STP/Jupiter Z-axis Bottom Motor End Cover.STEP
210.0 x 12.0 x 94.5 mm
