elegooofficial/Jupiter/Jupiter Mechanical/ASM/Jupiter Limit Switch Baffle.SLDPRT

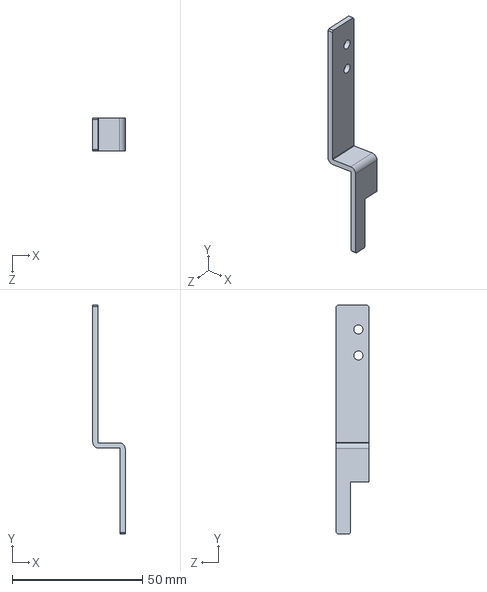
[picture p33: CAD file, 2022-12-16]
Jupiter Mechanical/ASM/Jupiter Limit Switch Baffle.SLDPRT
12.5 x 88.0 x 12.5 mm
