elegooofficial/Jupiter/Jupiter Mechanical/ASM/Jupiter Hood.SLDPRT

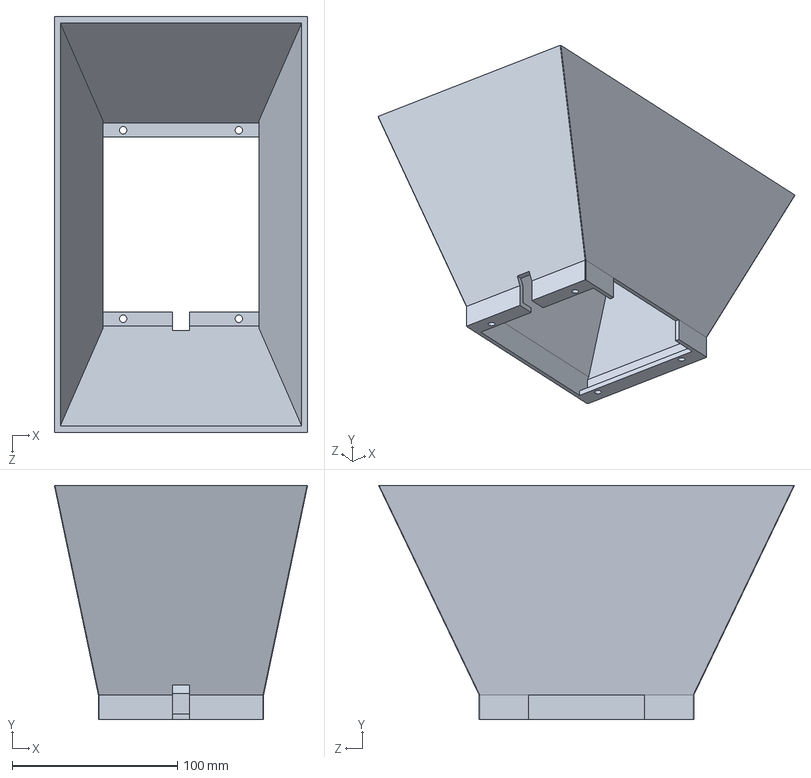
[picture p34: CAD file, 2022-12-16]
Jupiter Mechanical/ASM/Jupiter Hood.SLDPRT
153.2 x 141.7 x 251.6 mm
