elegooofficial/Jupiter/Jupiter Mechanical/ASM/Jupiter Z-axis Bottom Motor End Cover.SLDPRT

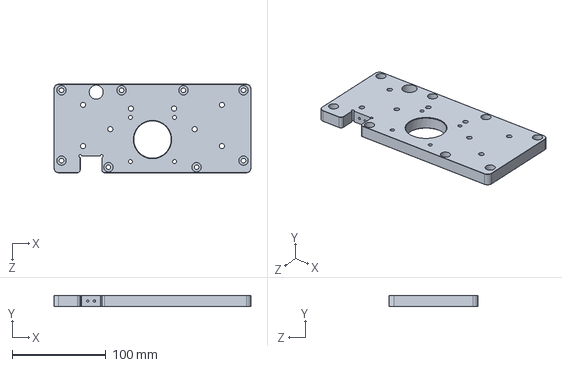
[picture p35: CAD file, 2022-12-16]
Jupiter Mechanical/ASM/Jupiter Z-axis Bottom Motor End Cover.SLDPRT
210.0 x 12.0 x 94.5 mm
