elegooofficial/Jupiter/Jupiter Mechanical/STP/Jupiter Build Plate.STEP

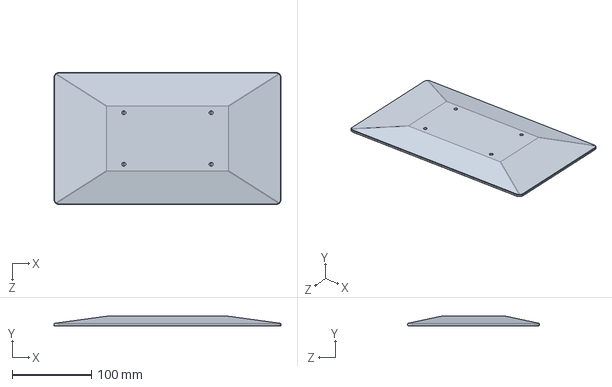
[picture p36: CAD file, 2022-12-16]
Jupiter Mechanical/STP/Jupiter Build Plate.STEP
286.0 x 12.0 x 166.0 mm
