elegooofficial/Jupiter/Jupiter Mechanical/ASM/Jupiter Top Panel.SLDPRT

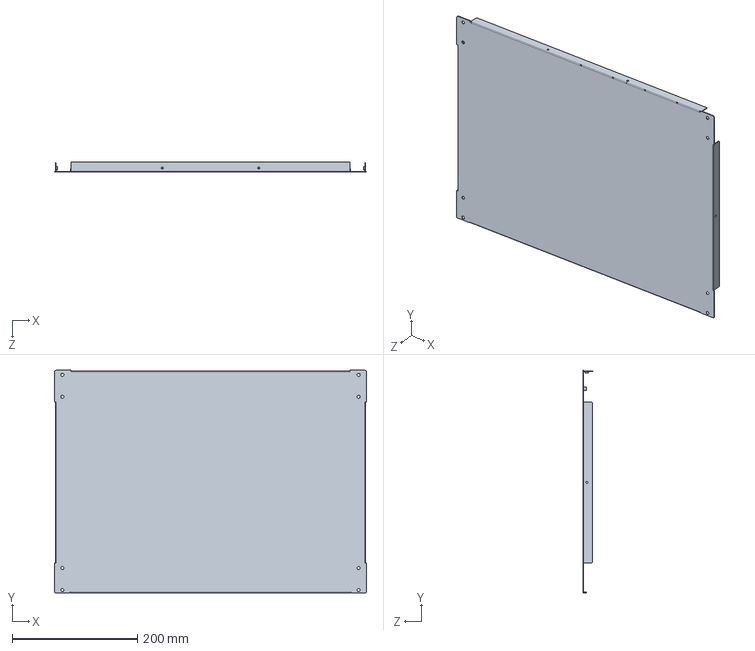
[picture p37: CAD file, 2022-12-16]
Jupiter Mechanical/ASM/Jupiter Top Panel.SLDPRT
498.0 x 355.5 x 16.0 mm
