elegooofficial/Jupiter/(list of files, cad)

Other CAD files:
Jupiter Mechanical/CAD/Jupiter Medium Plate.DWG
Jupiter Mechanical/STP/Jupiter Upper Back Panel.STEP
Jupiter Mechanical/STP/Jupiter Bottom Rear Left Profile.STEP
Jupiter Mechanical/STP/Jupiter Door Panel.STEP
Jupiter Mechanical/ASM/Jupiter Upper Front Right Profile.SLDPRT
Jupiter Mechanical/STP/Jupiter Bottom Rear Right Profile.STEP
Jupiter Mechanical/STP/Jupiter Cantilever Risers.STEP
Jupiter Mechanical/ASM/Jupiter Bottom Rear Right Profile.SLDPRT
Jupiter Mechanical/STP/Jupiter Heatsink.STEP
Jupiter Mechanical/STP/Jupiter Bottom Front Left Profile.STEP
Jupiter Mechanical/STP/Jupiter Bearing Holder.STEP
Jupiter Mechanical/STP/Jupiter Door Window.STEP
Jupiter Mechanical/ASM/Jupiter Lens.SLDPRT
Jupiter Mechanical/STP/Jupiter Forming Platform Upper Plate.STEP
Jupiter Mechanical/ASM/Jupiter Upper Front Left Profile.SLDPRT
Jupiter Mechanical/ASM/Jupiter Upper Left Panel.SLDPRT
Jupiter Mechanical/STP/Jupiter Upper Front Right Profile.STEP
Jupiter Mechanical/STP/Jupiter Upper Rear Right Profile.STEP
Jupiter Mechanical/STP/Jupiter Vent Cover Plate.STEP
Jupiter Mechanical/STP/Jupiter Linear Rails Backplane.STEP
Jupiter Mechanical/ASM/Jupiter Bottom Right Panel.SLDPRT
Jupiter Mechanical/STP/Jupiter Upper Right Panel.STEP
Jupiter Mechanical/ASM/Jupiter Printing Platform Integral Fixing Plate.SLDPRT
Jupiter Mechanical/STP/Jupiter Z-axis Slider Mounting Plate.STEP
Jupiter Mechanical/ASM/Jupiter Die Casting Resin Tank.SLDPRT
Jupiter Mechanical/STP/Jupiter Bottom Rear Mid Profile.STEP
Jupiter Mechanical/ASM/Jupiter Lens Pressing Plate.SLDPRT
Jupiter Mechanical/STP/Jupiter Bottom Front Right Profile.STEP
Jupiter Mechanical/ASM/Jupiter Bottom Front Panel.SLDPRT
Jupiter Mechanical/STP/Jupiter Upper Rear Left Profile.STEP
Jupiter Mechanical/ASM/Jupiter Bottom Front Left Profile.SLDPRT
Jupiter Mechanical/STP/Jupiter Top Panel.STEP
Jupiter Mechanical/ASM/Jupiter Build Plate.SLDPRT
Jupiter Mechanical/STP/Jupiter Lens Holder.STEP
Jupiter Mechanical/ASM/Jupiter Upper Rear Right Profile.SLDPRT
Jupiter Mechanical/ASM/Jupiter Screen Mounting Plate - Oil Injected Black.SLDPRT
Jupiter Mechanical/STP/Jupiter Hood.STEP
Jupiter Mechanical/ASM/Jupiter Bottom Front Right Profile.SLDPRT
Jupiter Mechanical/STP/Jupiter Bottom Rear Panel.STEP
Jupiter Mechanical/ASM/Jupiter Bottom Left Panel.SLDPRT
Jupiter Mechanical/ASM/Jupiter Ball Screw Nut Holder.SLDPRT
Jupiter Mechanical/ASM/Jupiter Lead Screw Lock Nut.SLDPRT
Jupiter Mechanical/CAD/Jupiter Ball Screw Nut Holder.DWG
Jupiter Mechanical/CAD/Jupiter Base Plate.DWG
Jupiter Mechanical/CAD/Jupiter Bottom Front Left Profile.DWG
Jupiter Mechanical/CAD/Jupiter Bottom Front Panel.DWG
Jupiter Mechanical/CAD/Jupiter Bottom Front Right Profile.DWG
Jupiter Mechanical/CAD/Jupiter Bottom Left Panel.DWG
Jupiter Mechanical/CAD/Jupiter Bottom Rear Left Profile.DWG
Jupiter Mechanical/CAD/Jupiter Bottom Rear Mid Profile.DWG
Jupiter Mechanical/CAD/Jupiter Bottom Rear Panel.DWG
Jupiter Mechanical/CAD/Jupiter Bottom Rear Right Profile.DWG
Jupiter Mechanical/CAD/Jupiter Bottom Right Panel.DWG
Jupiter Mechanical/CAD/Jupiter Build Plate.DWG
Jupiter Mechanical/CAD/Jupiter Cantilever Risers.DWG
Jupiter Mechanical/CAD/Jupiter Door Panel.DWG
Jupiter Mechanical/CAD/Jupiter Door Window.DWG
Jupiter Mechanical/CAD/Jupiter Forming Platform Upper Plate.DWG
Jupiter Mechanical/CAD/Jupiter Hood.DWG
Jupiter Mechanical/CAD/Jupiter Lead Screw Lock Nut.DWG
Jupiter Mechanical/CAD/Jupiter Lens Holder.DWG
Jupiter Mechanical/CAD/Jupiter Lens Pressing Plate.DWG
Jupiter Mechanical/CAD/Jupiter Lens.DWG
Jupiter Mechanical/CAD/Jupiter Limit Switch Baffle.DWG
Jupiter Mechanical/CAD/Jupiter Linear Rails Backplane.DWG
Jupiter Mechanical/CAD/Jupiter Printing Platform Integral Fixing Plate.DWG
Jupiter Mechanical/CAD/Jupiter Screen Mounting Plate - Oil Injected Black.DWG
Jupiter Mechanical/CAD/Jupiter Top Panel.DWG
Jupiter Mechanical/CAD/Jupiter Upper Back Panel.DWG
Jupiter Mechanical/CAD/Jupiter Upper Front Left Profile.DWG
Jupiter Mechanical/CAD/Jupiter Upper Front Right Profile.DWG
Jupiter Mechanical/CAD/Jupiter Upper Left Panel.DWG
Jupiter Mechanical/CAD/Jupiter Upper Rear Left Profile.DWG
Jupiter Mechanical/CAD/Jupiter Upper Rear Right Profile.DWG
Jupiter Mechanical/CAD/Jupiter Upper Right Panel.DWG
Jupiter Mechanical/CAD/Jupiter Vent Cover Plate.DWG
Jupiter Mechanical/CAD/Jupiter Z-axis Bottom Motor End Cover.DWG
Jupiter Mechanical/CAD/Jupiter Z-axis Slider Mounting Plate.DWG
Jupiter Mechanical/STP/Jupiter Ball Screw Nut Holder.STEP
Jupiter Mechanical/STP/Jupiter Lead Screw Lock Nut.STEP
