elegooofficial/Jupiter/Jupiter PCB/Jupiter-PCB Adapter Board/TOP-Jupiter-V4.0.pdf

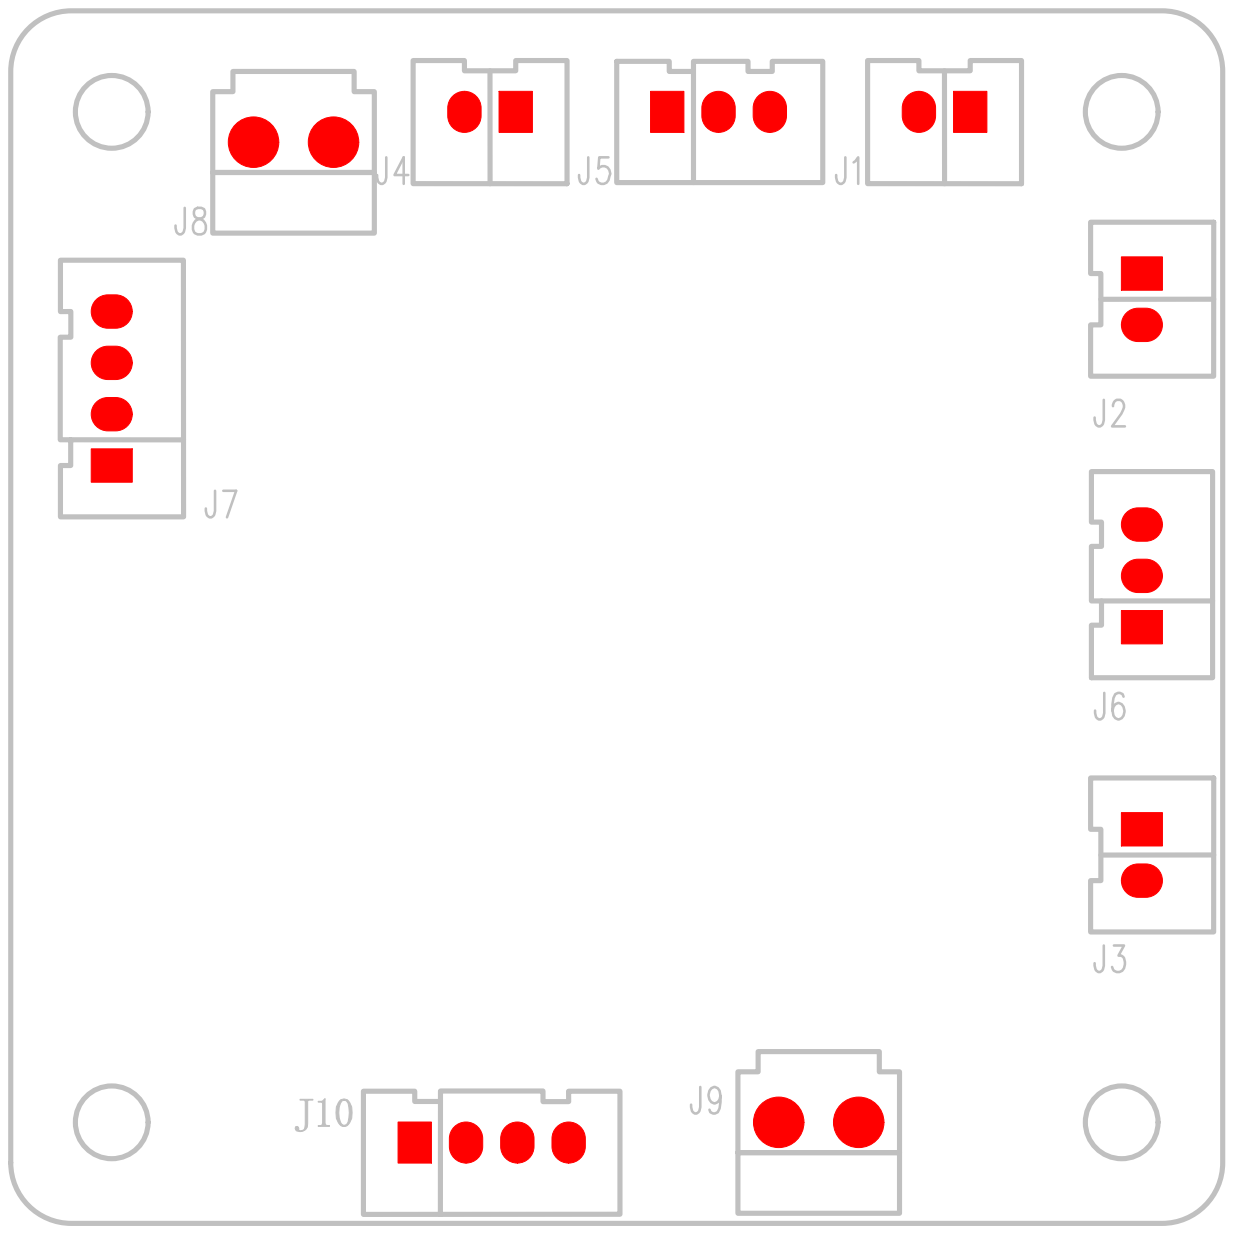
[picture p88: page 1]
