elegooofficial/Jupiter/Jupiter Mechanical/PDF/Jupiter Bottom Right Panel.pdf

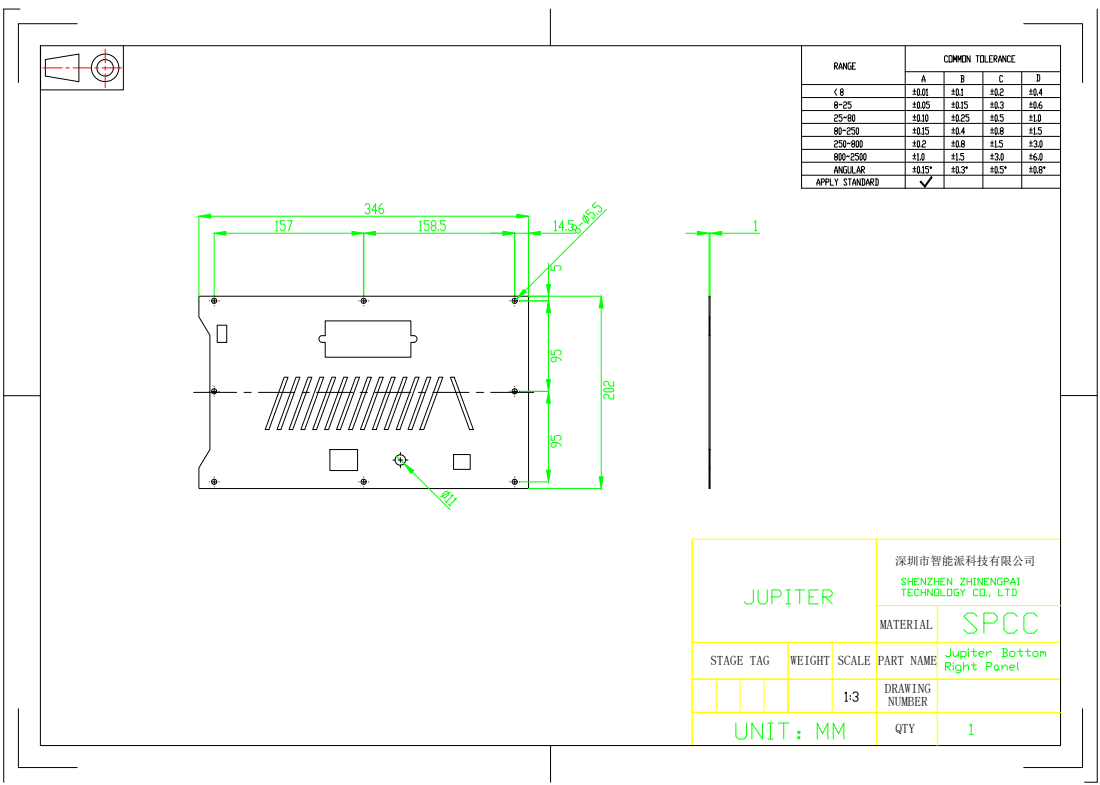
[picture p48: page 1]
深圳市智能派科技有限公司 STAGE TAG; WEIGHT; SCALE; DRAWING NUMBER PART NAME QTY MATERIAL ：
