elegooofficial/Jupiter/Jupiter Mechanical/PDF/Jupiter Door Panel.pdf

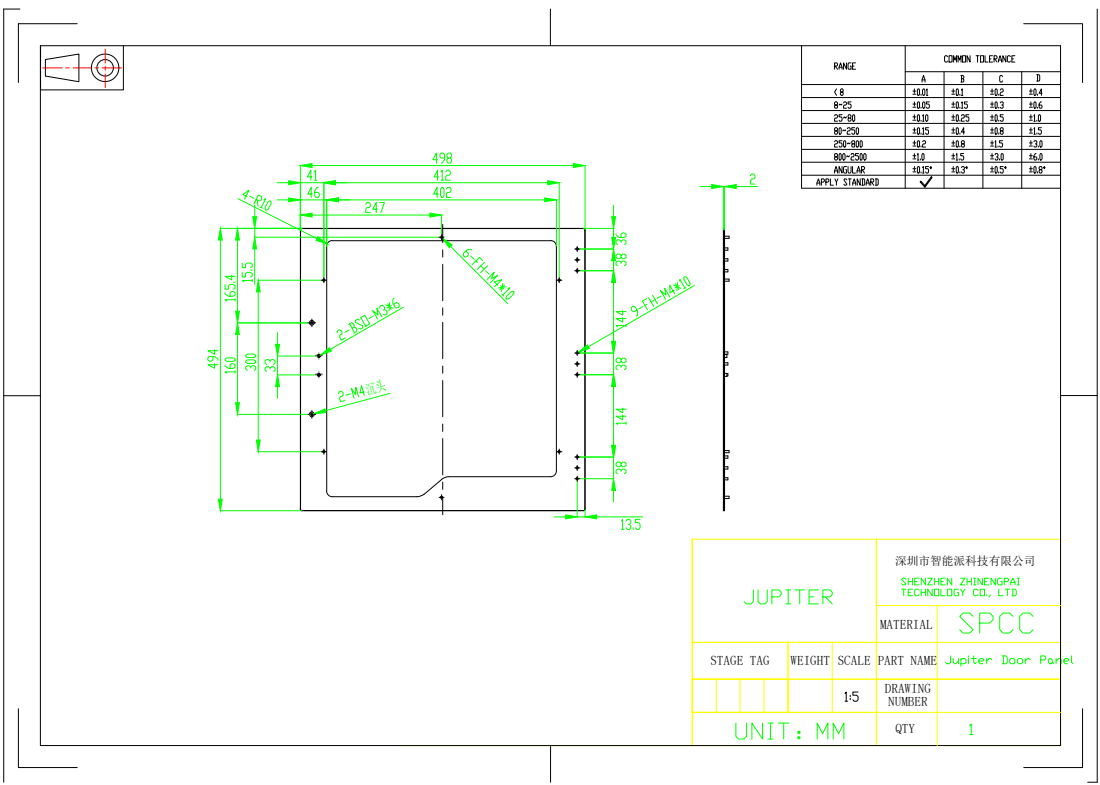
[picture p51: page 1]
深圳市智能派科技有限公司 STAGE TAG; WEIGHT; SCALE; DRAWING NUMBER PART NAME QTY MATERIAL ：
