elegooofficial/Jupiter/Jupiter Mechanical/PDF/Jupiter Forming Platform Upper Plate.pdf

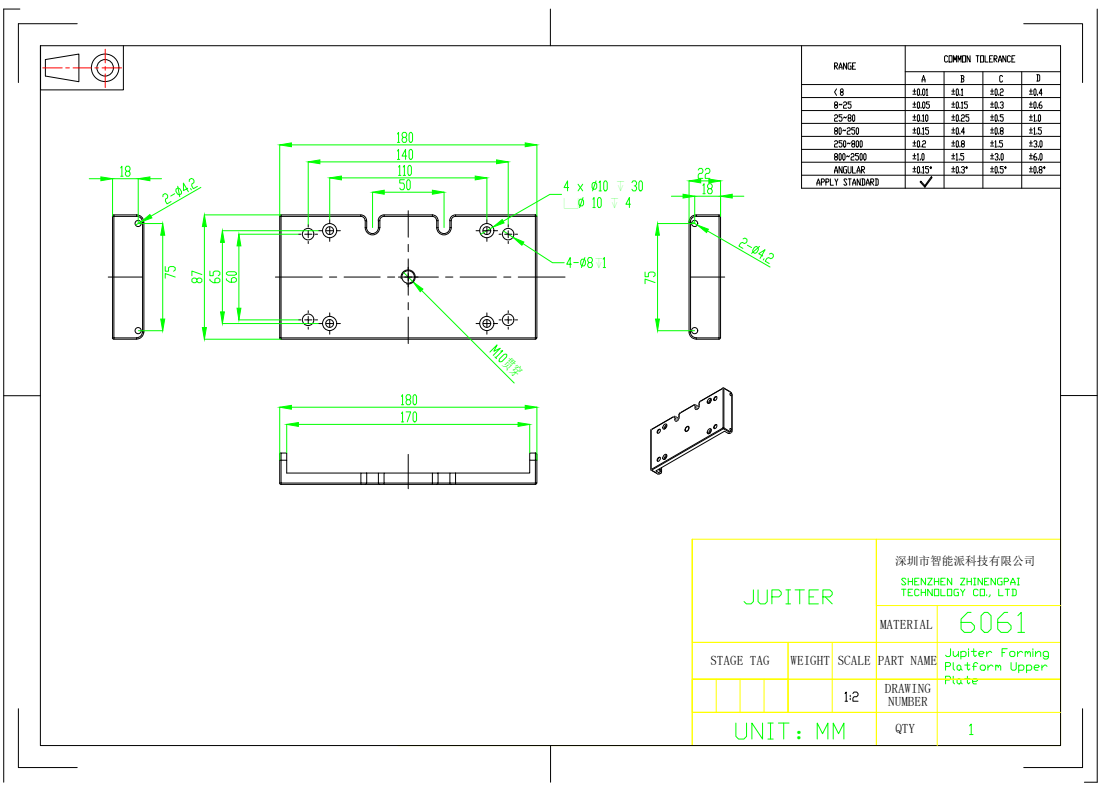
[picture p53: page 1]

贯穿     深圳市智能派科技有限公司 STAGE TAG WEIGHT SCALE DRAWING NUMBER PART NAME QTY MATERIAL ：
