elegooofficial/Jupiter/Jupiter Mechanical/PDF/Jupiter Printing Platform Integral Fixing Plate.pdf

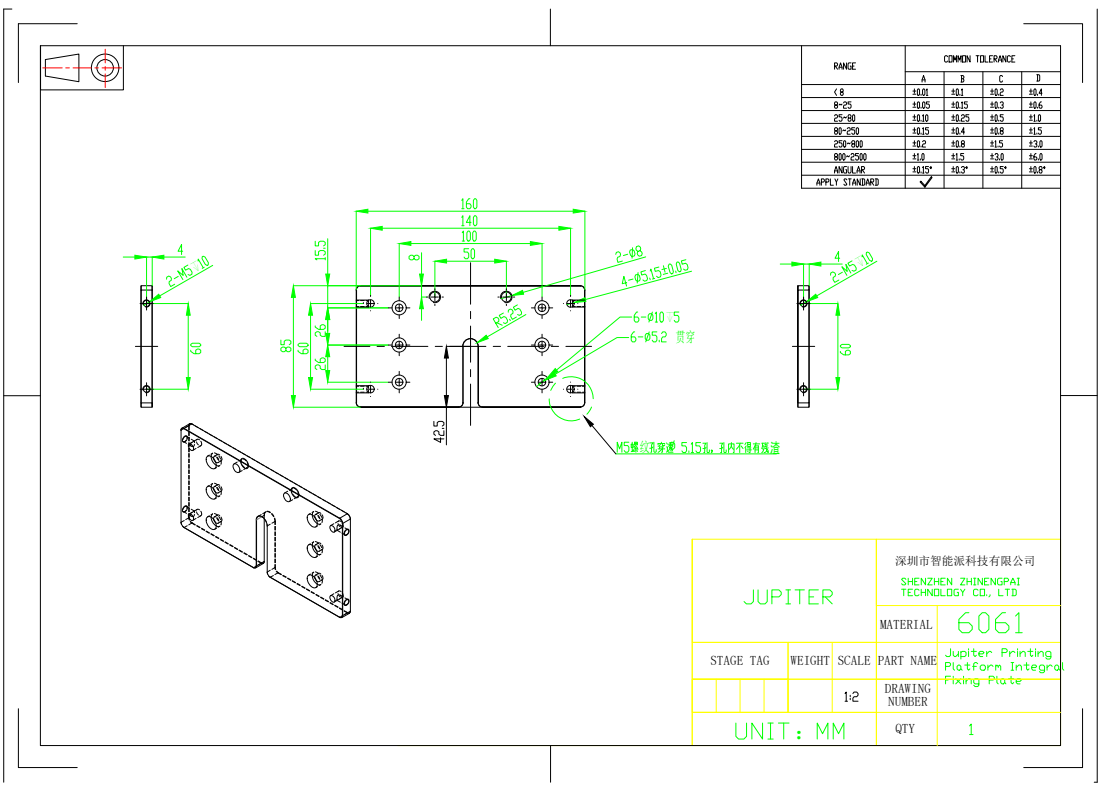
[picture p61: page 1]
深圳市智能派科技有限公司 STAGE TAG; WEIGHT; SCALE; DRAWING NUMBER PART NAME QTY MATERIAL ：
