elegooofficial/Jupiter/Jupiter Wiring/Jupiter Booster Board to Motherboard Cable.pdf

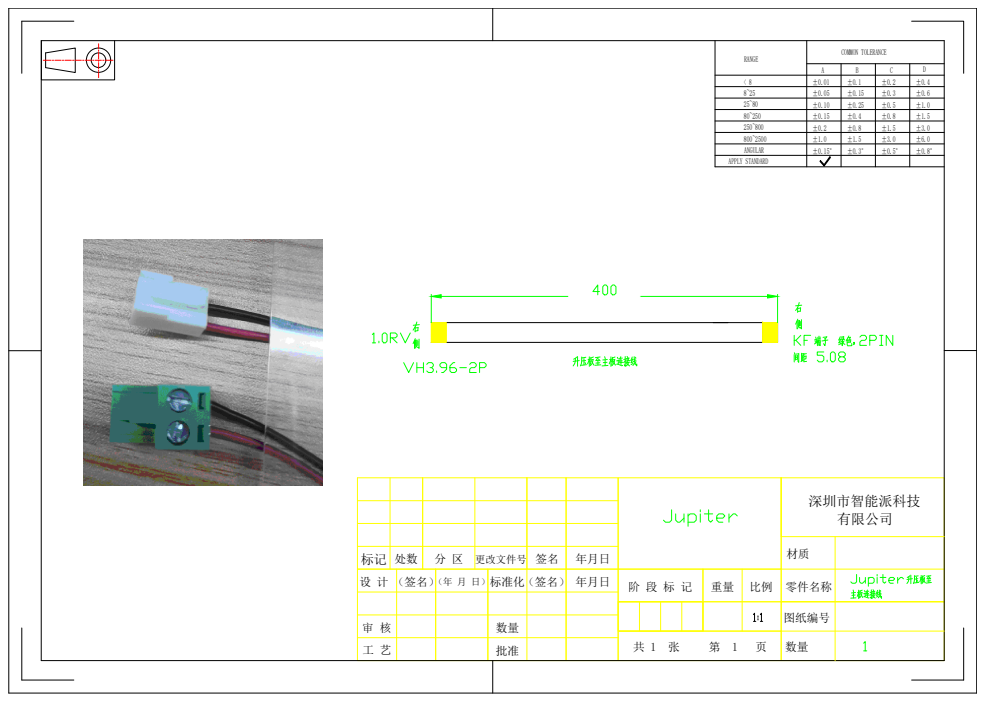
[picture p72: page 1]
C COMMON TOLERANCE±3.0 ±1.5 ±0.5° ±0.8 ±1.5 ±0.3° A < 8 RANGE 25~80 80~250 8~25 800~2500 ANGULAR APPLY STANDARD 250~800

标记 | 处数 | 分 区 | 更改文件号 | 签名 | 年月日

设 计 （签名）（年 月 日） | | | 标准化（签名） 年月日 | | | 阶 段 标 记 | 重量 | 比例 | 零件名称

图纸编号
