elegooofficial/Jupiter/Jupiter Wiring/Jupiter Fan Adapter Cable.pdf

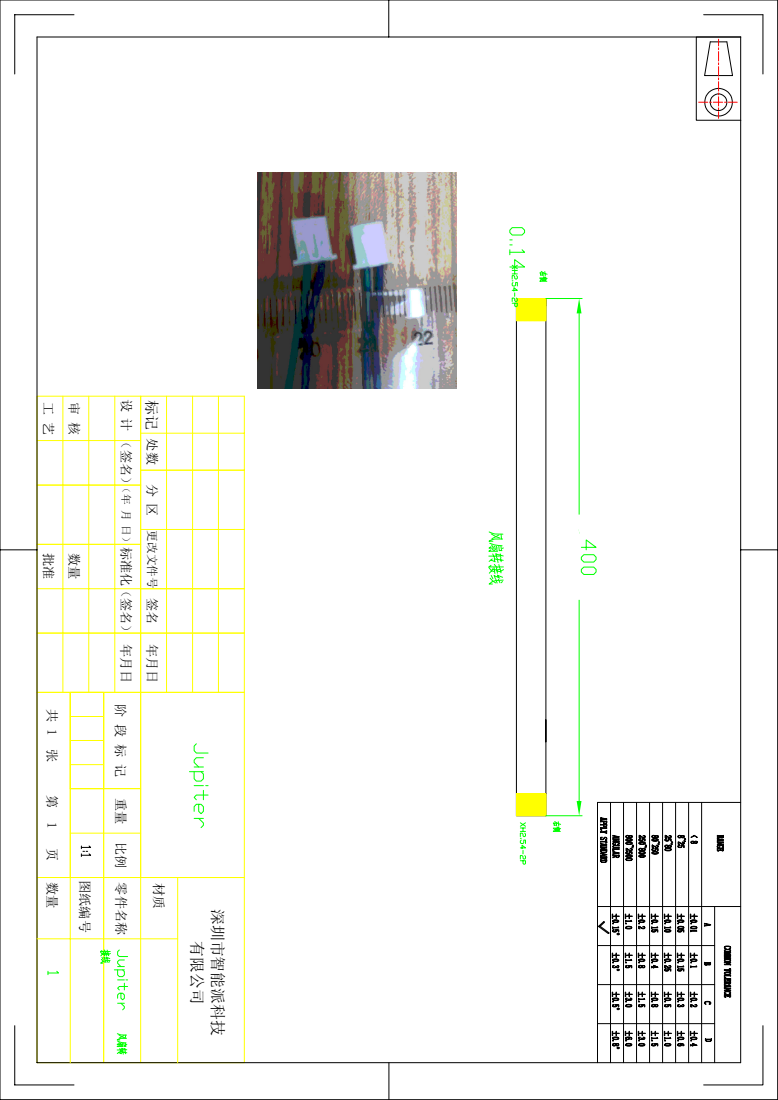
[picture p73: page 1]
深圳市智能派科技; 有限公司; 图纸编号; 零件名称

标记 处数 分 区 更改文件号 签名 年月日

标准化（签名） 年月日
