elegooofficial/Jupiter/Jupiter Mechanical/PDF/Jupiter Upper Front Right Profile.pdf

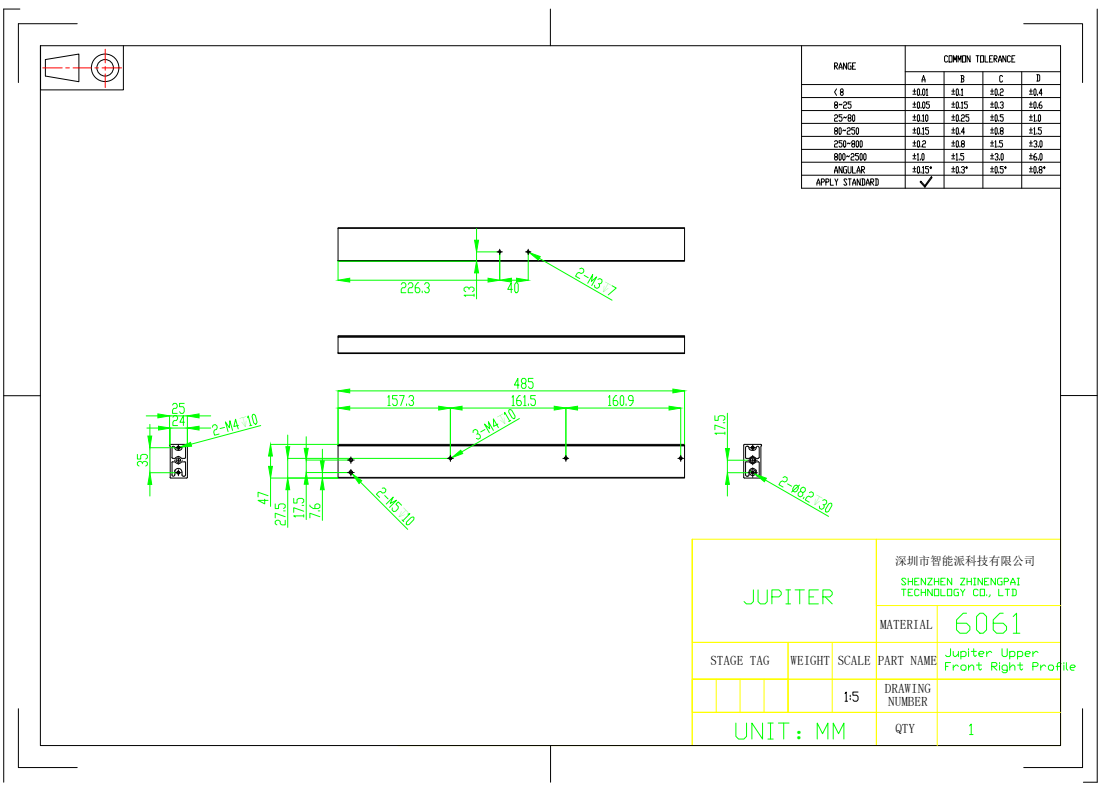
[picture p82: page 1]
