elegooofficial/Jupiter/Jupiter Mechanical/PDF/Jupiter Z-axis Slider Mounting Plate.pdf

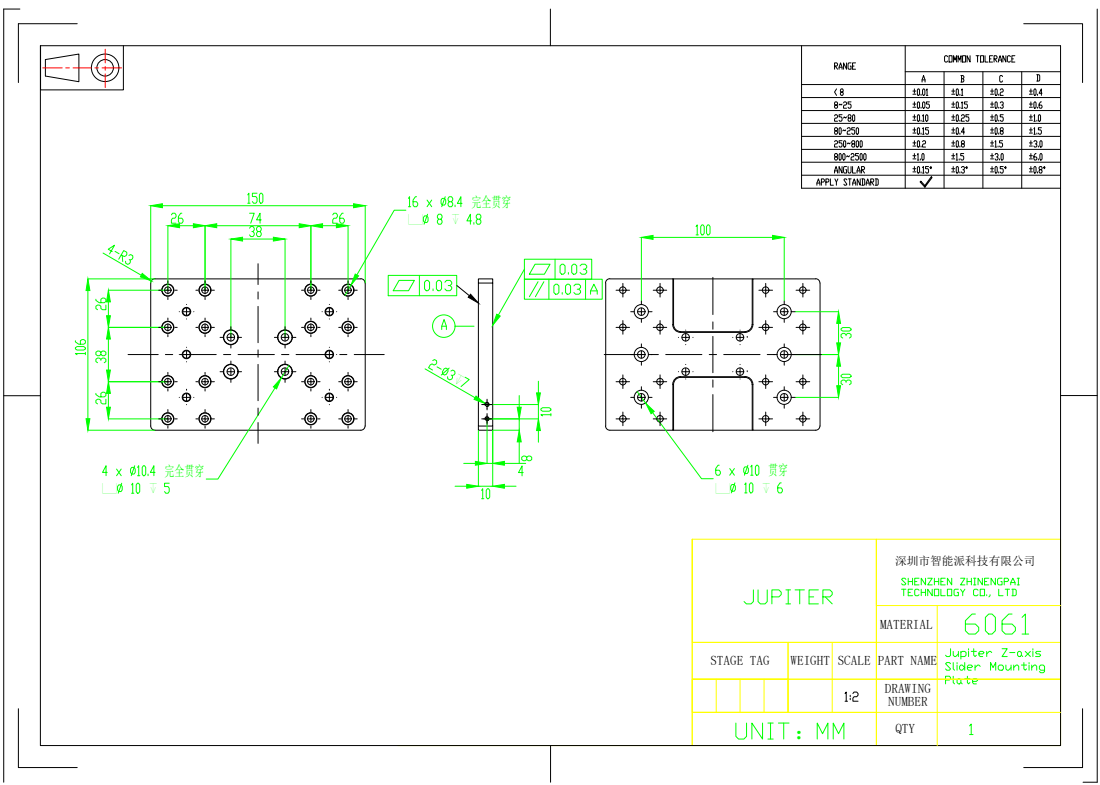
[picture p83: page 1]
