elegooofficial/Jupiter/Jupiter PCB/Jupiter-Constant-current module/BOT.pdf

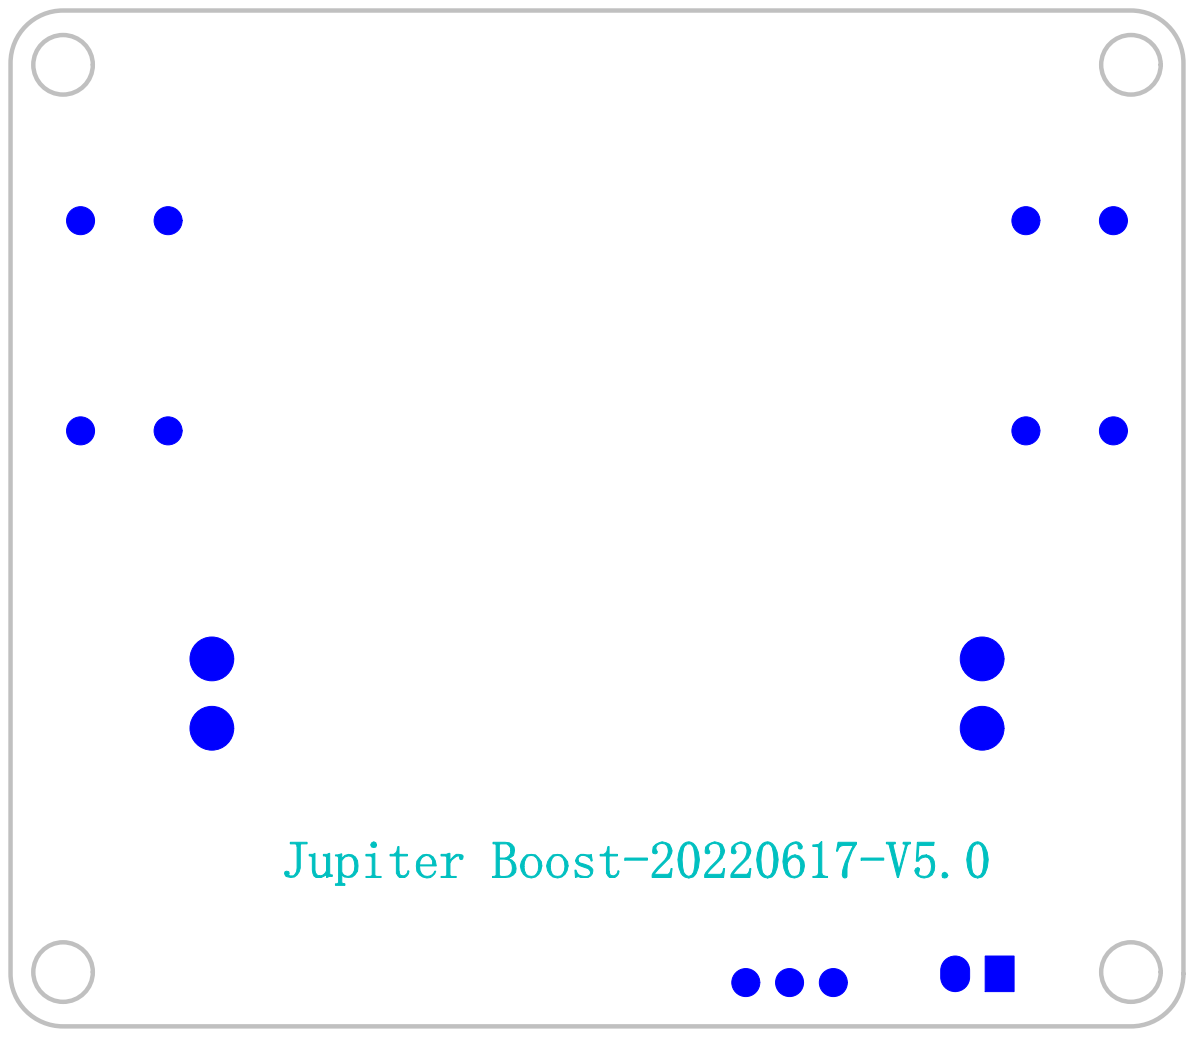
[picture p84: page 1]
Jupiter Boost-20220617-V5.0
