elegooofficial/Jupiter/Jupiter PCB/Jupiter-Constant-current module/TOP.pdf

C2

D4

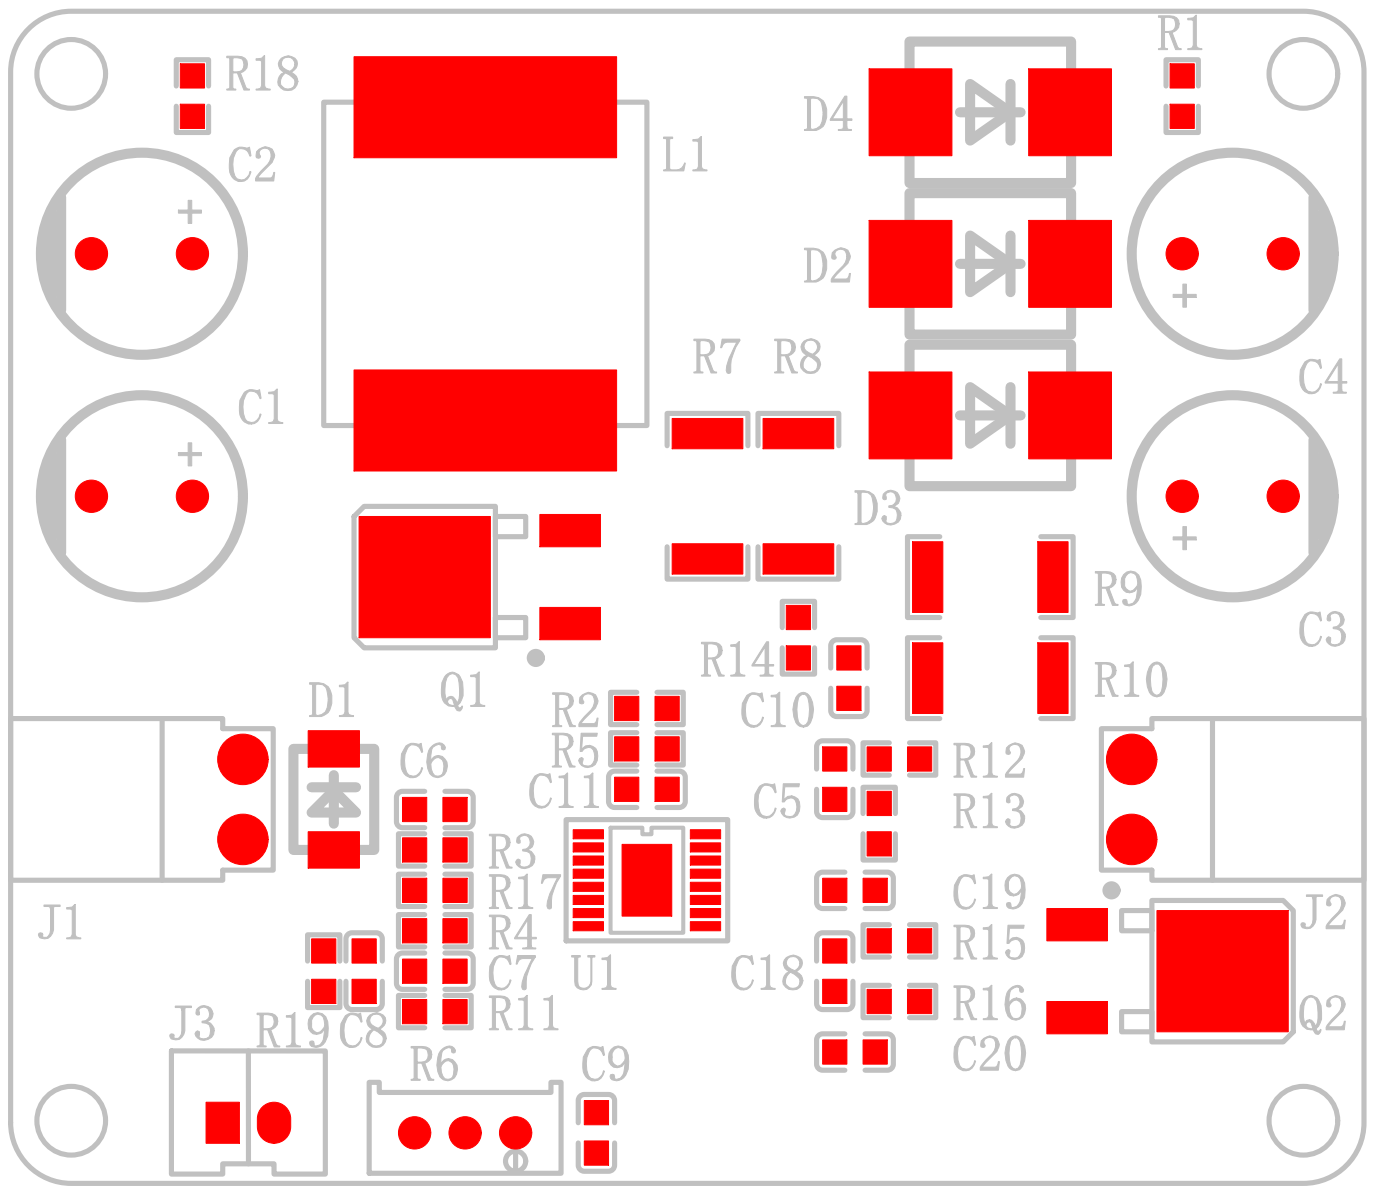
[picture p85: page 1]
