elegooofficial/Jupiter/Jupiter PCB/Jupiter-Constant-current module/原理图.pdf

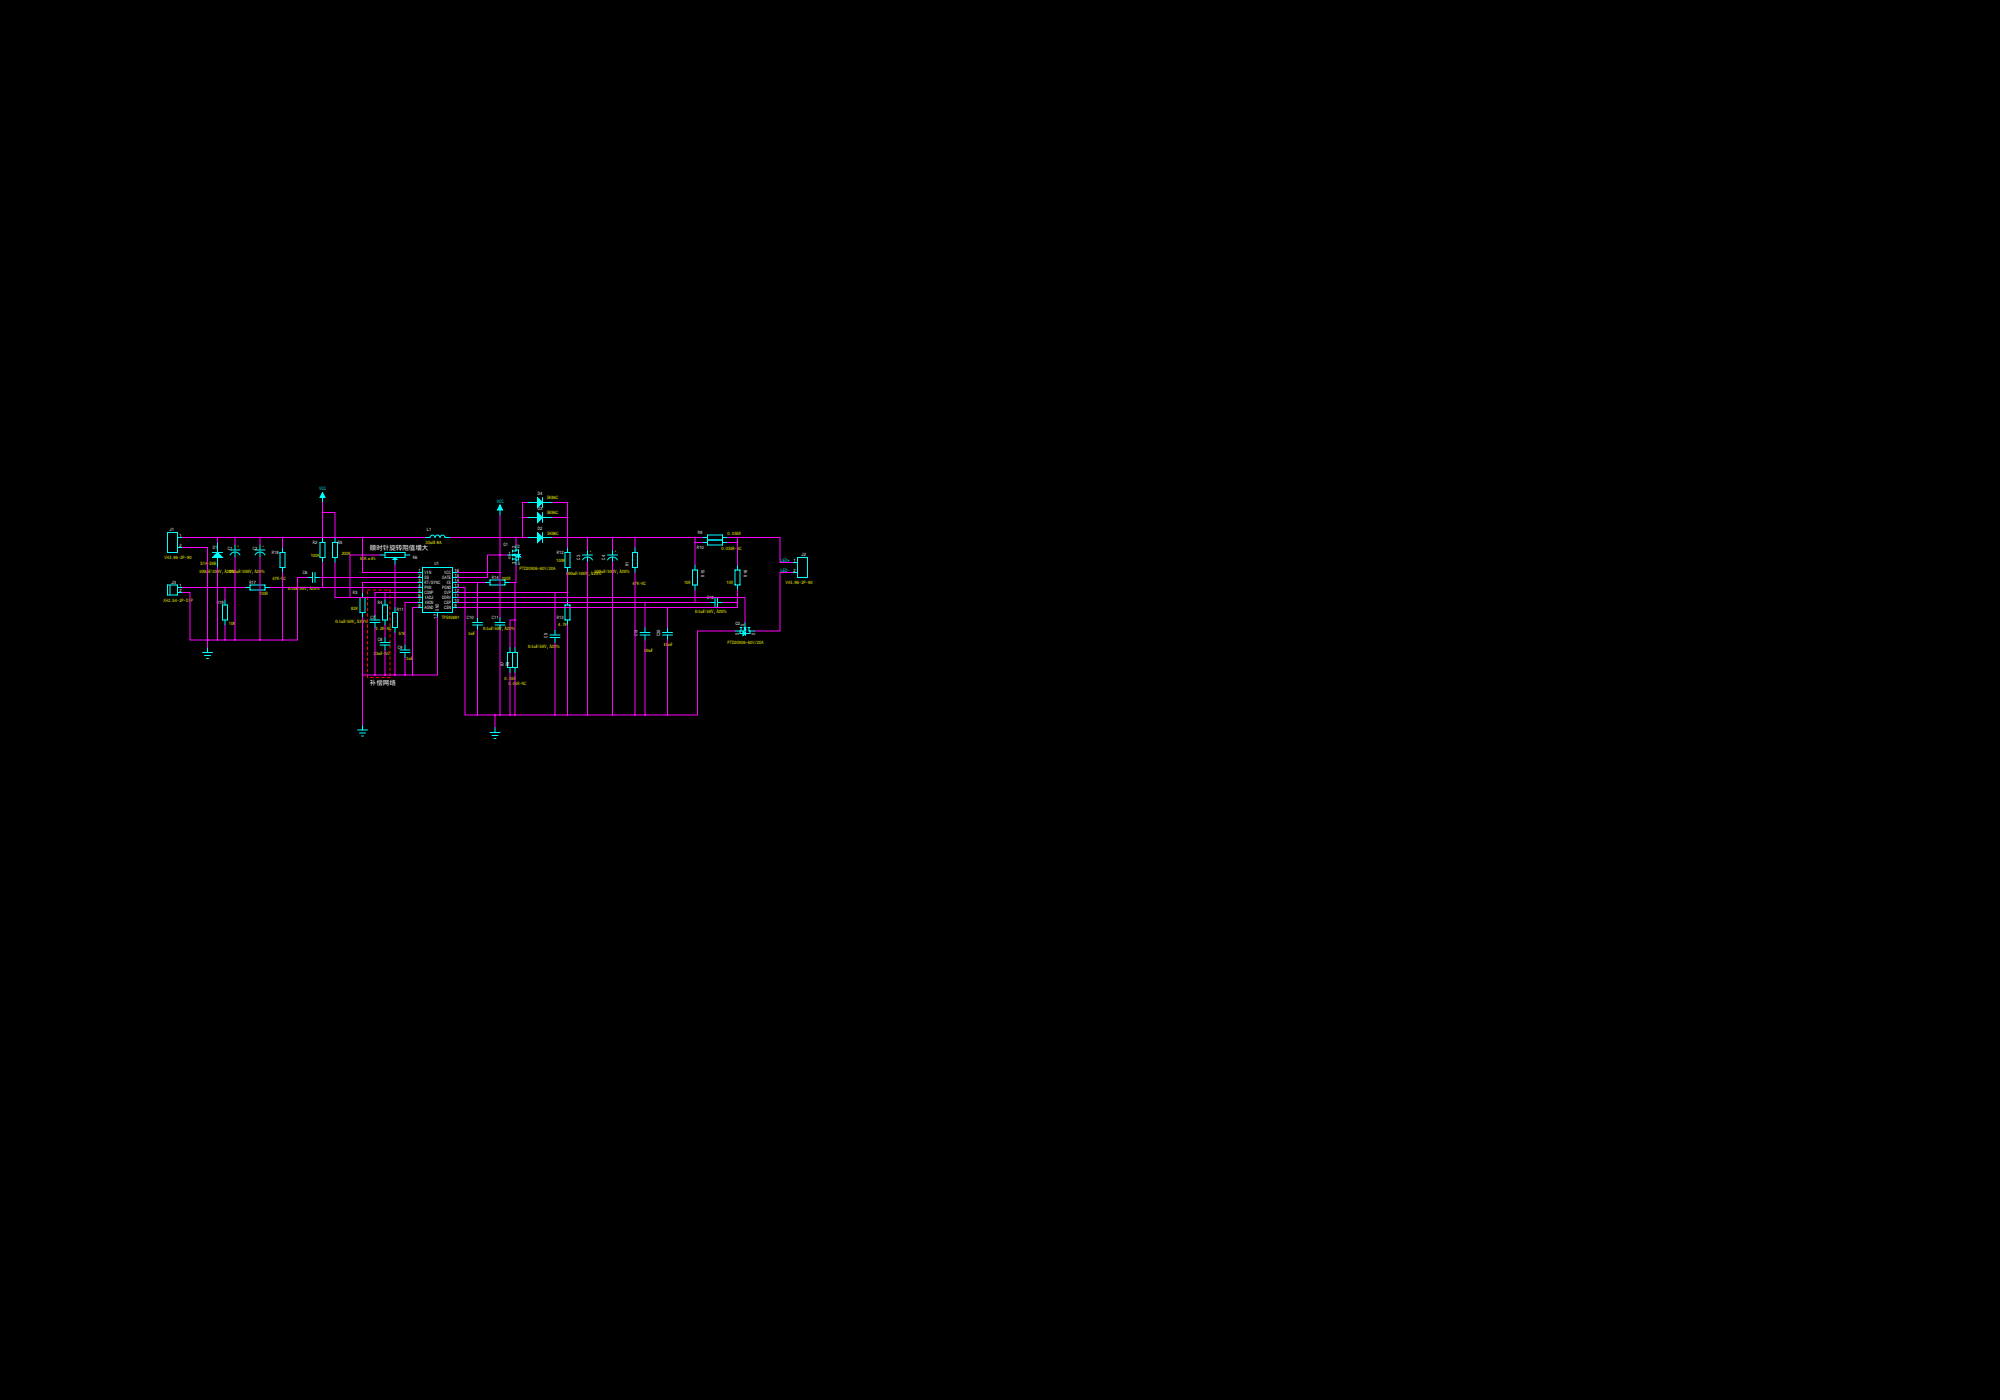
[picture p86: page 1]
