elegooofficial/Jupiter/Jupiter PCB/Jupiter-PCB Adapter Board/BOT-Jupiter  -V4.0.pdf

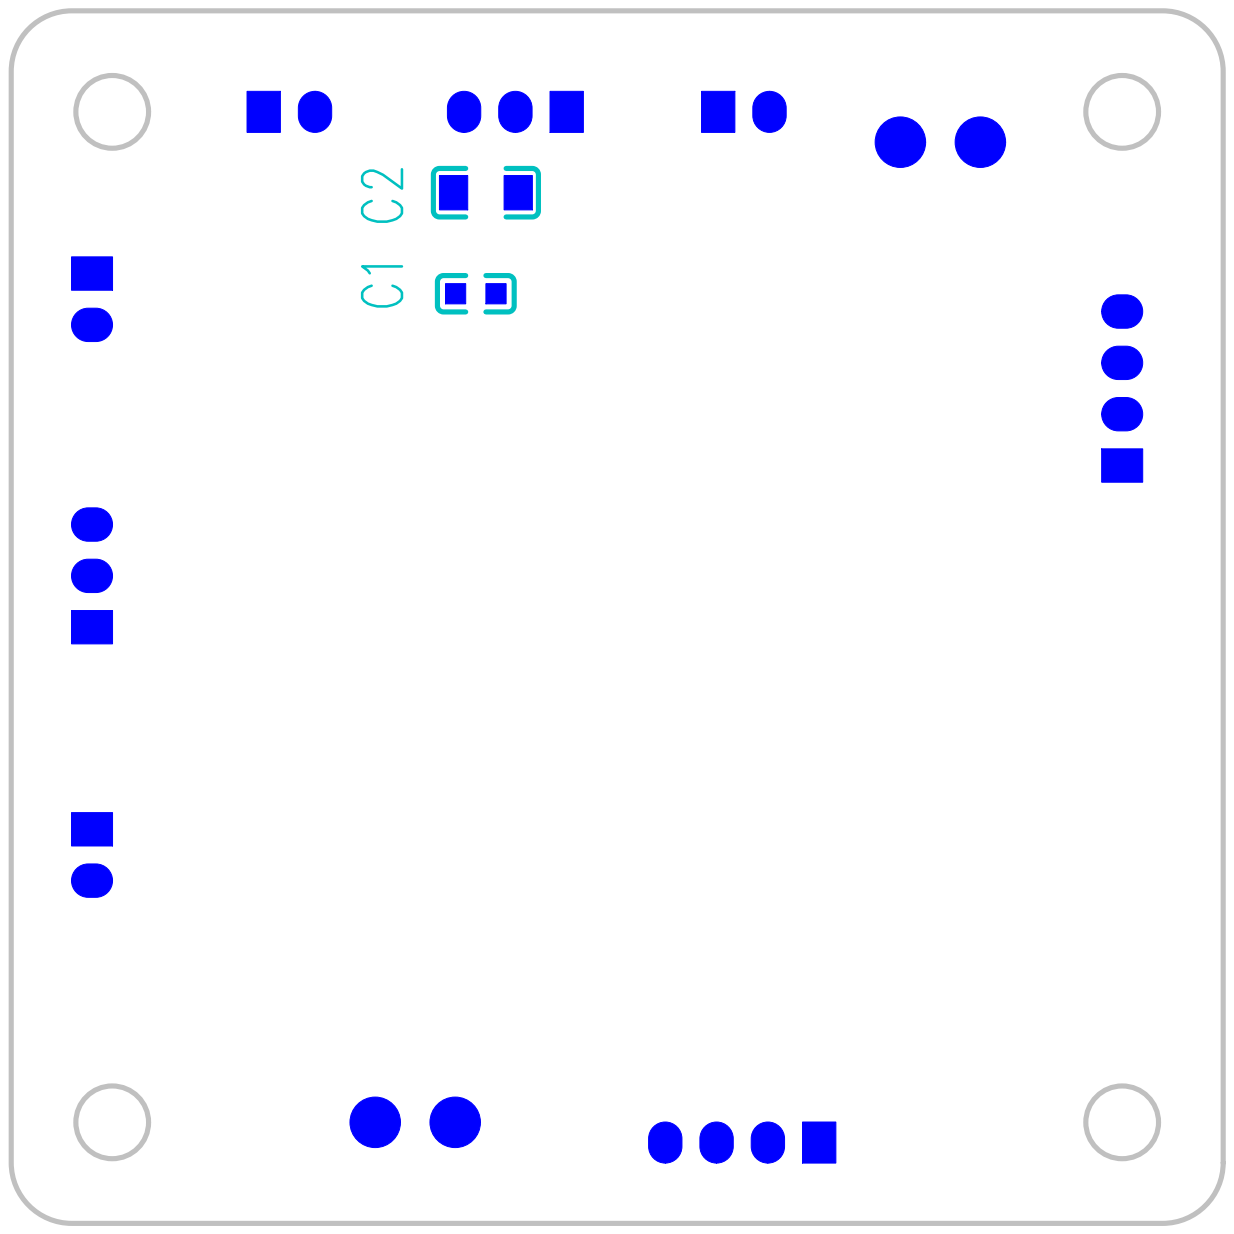
[picture p87: page 1]
