elegooofficial/Jupiter/Jupiter PCB/Jupiter-PCB Adapter Board/TOP-Jupiter-V4.0.pdf

J1

J4 | J5
